SeguierMaximilien/GouGouGaGAH_DomotiqueESP32/docs/dossier_conception/Dossier_conception_AssistDomo_SEGUIER.pdf

# IUT de Toulon, département GEII SAE3.ESE.01-02 Concevoir-Vérifier

# Dossier de conception

# Assistant domotique « Yuki » ESP32-C6 et Home Assistant

# Schéma fonctionnel · Schéma structurel · Captures Home Assistant Annexes : code Arduino, codes et configuration Home Assistant

# Maximilien SEGUIER Enseignant : M. GIBERT Rendu le 1er novembre 2026

# Sommaire

# 1. Schéma fonctionnel

# 2. Schéma structurel (KiCad)

# 3. Captures d'écran Home Assistant

# Annexe A. Code Arduino du programme final

# Annexe B. Codes et configuration Home Assistant

# Présentation du système

L'assistant domotique Yuki affiche des informations sur l'habitation et permet de la piloter. Une

# carte à base de nanoESP32-C6 mesure la lumière (BH1750), la température et la pression

(BMP280) et la présence de gaz (MQ). Elle lit les badges RFID (RC522) pour commander la gâche de la porte par le relais K1, affiche les données sur un écran tactile ILI9341 et fournit une sortie PWM pour la gradation d'un éclairage ou la vitesse d'une VMC. La LED RGB de la carte indique la couleur Tempo EDF du jour et du lendemain et clignote pour attester que le programme tourne.

# La carte communique en WiFi avec Home Assistant (Raspberry Pi 3) par le protocole MQTT :

les entités sont créées automatiquement par la découverte MQTT, avec historique, tableau de bord et automatisations. Le tableau de bord est accessible sur le réseau local et à distance par le VPN Tailscale, sans ouverture de port sur la box.

Dossier de conception AssistDomo - SAE3.ESE.01-02 - Maximilien SEGUIER | 2 / 27

# 1. Schéma fonctionnel

# Habitation

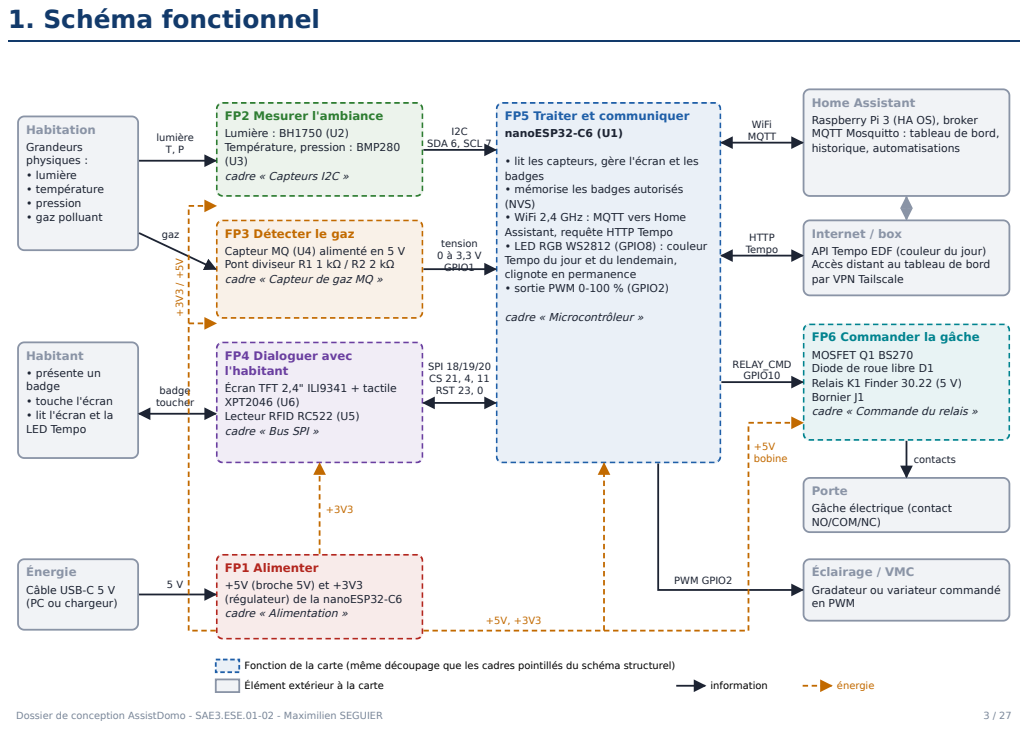
[picture p1: page 3]
Grandeurs physiques : • lumière • température • pression • gaz polluant; FP2 Mesurer l'ambiance Lumière : BH1750 (U2) Température, pression : BMP280 (U3) cadre « Capteurs I2C »; cadre « Microcontrôleur »; lumière T, P; gaz; badge toucher; I2C SDA 6, SCL 7; tension 0 à 3,3 V GPIO1; SPI 18/19/20 CS 21, 4, 11 RST 23, 0; WiFi MQTT; HTTP Tempo; RELAY_CMD GPIO10; contacts; PWM GPIO2 5 V; +5V bobine; Élément extérieur à la carte; information; énergie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

Home Assistant
Raspberry Pi 3 (HA OS), broker
MQTT Mosquitto : tableau de bord,
historique, automatisations

FP5 Traiter et communiquer
nanoESP32-C6 (U1)

• lit les capteurs, gère l'écran et les
badges
• mémorise les badges autorisés
(NVS)
• WiFi 2,4 GHz : MQTT vers Home
Assistant, requête HTTP Tempo
• LED RGB WS2812 (GPIO8) : couleur
Tempo du jour et du lendemain,
clignote en permanence
• sortie PWM 0-100 % (GPIO2)

FP3 Détecter le gaz
Capteur MQ (U4) alimenté en 5 V
Pont diviseur R1 1 kΩ / R2 2 kΩ
cadre « Capteur de gaz MQ »

Internet / box
API Tempo EDF (couleur du jour)
Accès distant au tableau de bord
par VPN Tailscale

FP6 Commander la gâche
MOSFET Q1 BS270
Diode de roue libre D1
Relais K1 Finder 30.22 (5 V)
Bornier J1
cadre « Commande du relais »

Habitant
• présente un
badge
• touche l'écran
• lit l'écran et la
LED Tempo

FP4 Dialoguer avec
l'habitant
Écran TFT 2,4" ILI9341 + tactile
XPT2046 (U6)
Lecteur RFID RC522 (U5)
cadre « Bus SPI »

Porte
Gâche électrique (contact
NO/COM/NC)

Énergie
Câble USB-C 5 V
(PC ou chargeur)

FP1 Alimenter
+5V (broche 5V) et +3V3
(régulateur) de la nanoESP32-C6
cadre « Alimentation »

Éclairage / VMC
Gradateur ou variateur commandé
en PWM

Fonction de la carte (même découpage que les cadres pointillés du schéma structurel)

# Description des fonctions

Fonction | Composants | Rôle
FP1 Alimenter | nanoESP32-C6 (U1) : broches 5V et 3V3 | Fournit le +5V (MQ, bobine du relais) et le +3V3 (capteurs I2C, écran, RFID) à partir de l'USB-C.
FP2 Mesurer l'ambiance | BH1750 GY-302 (U2), BMP280 (U3) | Mesure l'éclairement (lx), la température (°C) et la pression (hPa). Bus I2C partagé, adresses 0x23 et 0x76.
FP3 Détecter le gaz | Module MQ (U4), R1 1 kΩ, R2 2 kΩ | Donne une tension image de la concentration de gaz. Le pont diviseur ramène la sortie 0-5 V à 0-3,33 V pour l'entrée analogique GPIO1.
FP4 Dialoguer avec l'habitant | Écran TFT 2,4" ILI9341 + XPT2046 (U6), RC522 (U5) | Affiche les mesures et les menus, reçoit les appuis tactiles, lit l'identifiant des badges. Bus SPI partagé, un chip select par module.
FP5 Traiter et communiquer | nanoESP32-C6 (U1) | Exécute le programme : contrôle d'accès, menus, mémoire des badges en NVS, MQTT vers Home Assistant, lecture de la couleur Tempo, LED RGB, sortie PWM.
FP6 Commander la gâche | BS270 (Q1), D1, relais Finder 30.22.7.005 (K1), bornier J1 | Le MOSFET commute la bobine 5 V du relais depuis GPIO10. D1 protège Q1 de la surtension à la coupure. Les contacts NO/COM/NC sortent sur J1 vers la gâche.

# Liaisons entre fonctions

Liaison | Nature | Signaux (GPIO de l'ESP32-C6)
FP2 → FP5 | numérique, I2C | SDA = GPIO6, SCL = GPIO7
FP3 → FP5 | analogique | MQ_AO divisé, 0 à 3,33 V sur GPIO1 (ADC 12 bits)
FP4 ↔ FP5 | numérique, SPI | SCK = GPIO18, MOSI = GPIO19, MISO = GPIO20 ; TFT_CS = 21, TFT_DC = 22, TFT_RST = 23, TOUCH_CS = 4, RFID_CS = 11, RFID_RST = 0
FP5 → FP6 | logique TOR | RELAY_CMD = GPIO10, actif à l'état haut
FP5 → éclairage / VMC | PWM | GPIO2, rapport cyclique 0 à 100 %
FP5 → LED RGB | série WS2812 | GPIO8 (LED intégrée à la carte)
FP5 ↔ Home Assistant | WiFi 2,4 GHz, MQTT | topics gougougagah/… (voir annexe B)
FP5 ↔ Internet | WiFi, HTTP | api-couleur-tempo.fr : couleur du jour et du lendemain
Dossier de conception AssistDomo - SAE3.ESE.01-02 - Maximilien SEGUIER | 4 / 27

# 2. Schéma structurel

Le schéma structurel a été saisi sous KiCad 10 (projet mSeguier/mSeguier.kicad_sch). Il reprend le découpage du schéma fonctionnel : chaque fonction est entourée d'un cadre en trait pointillé (Alimentation, Microcontrôleur, Capteurs I2C, Capteur de gaz MQ, Bus SPI, Commande du relais). Le schéma est reproduit à la page suivante (original au format A3, en vectoriel : il peut être agrandi).

# Nomenclature des repères

Repère | Désignation | Fonction | Remarque
U1 | MuseLab nanoESP32-C6 (2 × 15 broches) | FP5, FP1 | Microcontrôleur, WiFi, LED RGB WS2812
U2 | Module GY-302 BH1750 | FP2 | ADDR à GND : adresse 0x23
U3 | Module GY-BMP280 | FP2 | CSB à 3V3 (mode I2C), SDO à GND : adresse 0x76
U4 | Module capteur de gaz MQ | FP3 | Alimenté en 5 V, DO non utilisé
R1, R2 | Résistances 1 kΩ et 2 kΩ | FP3 | 5 V × 2k / (1k + 2k) = 3,33 V max
U5 | Module RFID RC522 | FP4 | Alimenté en 3,3 V uniquement
U6 | Écran TFT 2,4" ILI9341 + tactile XPT2046 (MSP2402) | FP4 | Rétroéclairage sur 3V3
Q1 | MOSFET canal N BS270 | FP6 | Commande de la bobine depuis GPIO10
D1 | Diode 1N4004 | FP6 | Roue libre, cathode côté +5V
K1 | Relais Finder 30.22.7.005.0010, 2RT, bobine 5 V | FP6 | 1er inverseur utilisé
J1 | Bornier à vis 3 points | FP6 | 1 = NO, 2 = COM, 3 = NC

# Dimensionnement de la commande du relais

La bobine 5 V du relais Finder 30.22 consomme environ 40 mA (résistance d'environ 125 Ω). Une

# sortie de l'ESP32-C6 ne peut pas fournir ce courant sous 5 V : le MOSFET BS270 (VGS(th)

inférieure à 2,5 V, ID max 400 mA) est commandé directement en 3,3 V par GPIO10 et commute

# la bobine côté masse. La diode D1 en parallèle sur la bobine écoule le courant de self à

l'ouverture et protège Q1.

Dossier de conception AssistDomo - SAE3.ESE.01-02 - Maximilien SEGUIER | 5 / 27

# VCC 1 GND 2 SCL 3 SDA 4 ADDR 5 U2BH1750 (GY-302) SDA/SS 1 SCK 2 MOSI 3 MISO 4

# TOUCH_CS RELAY_NO

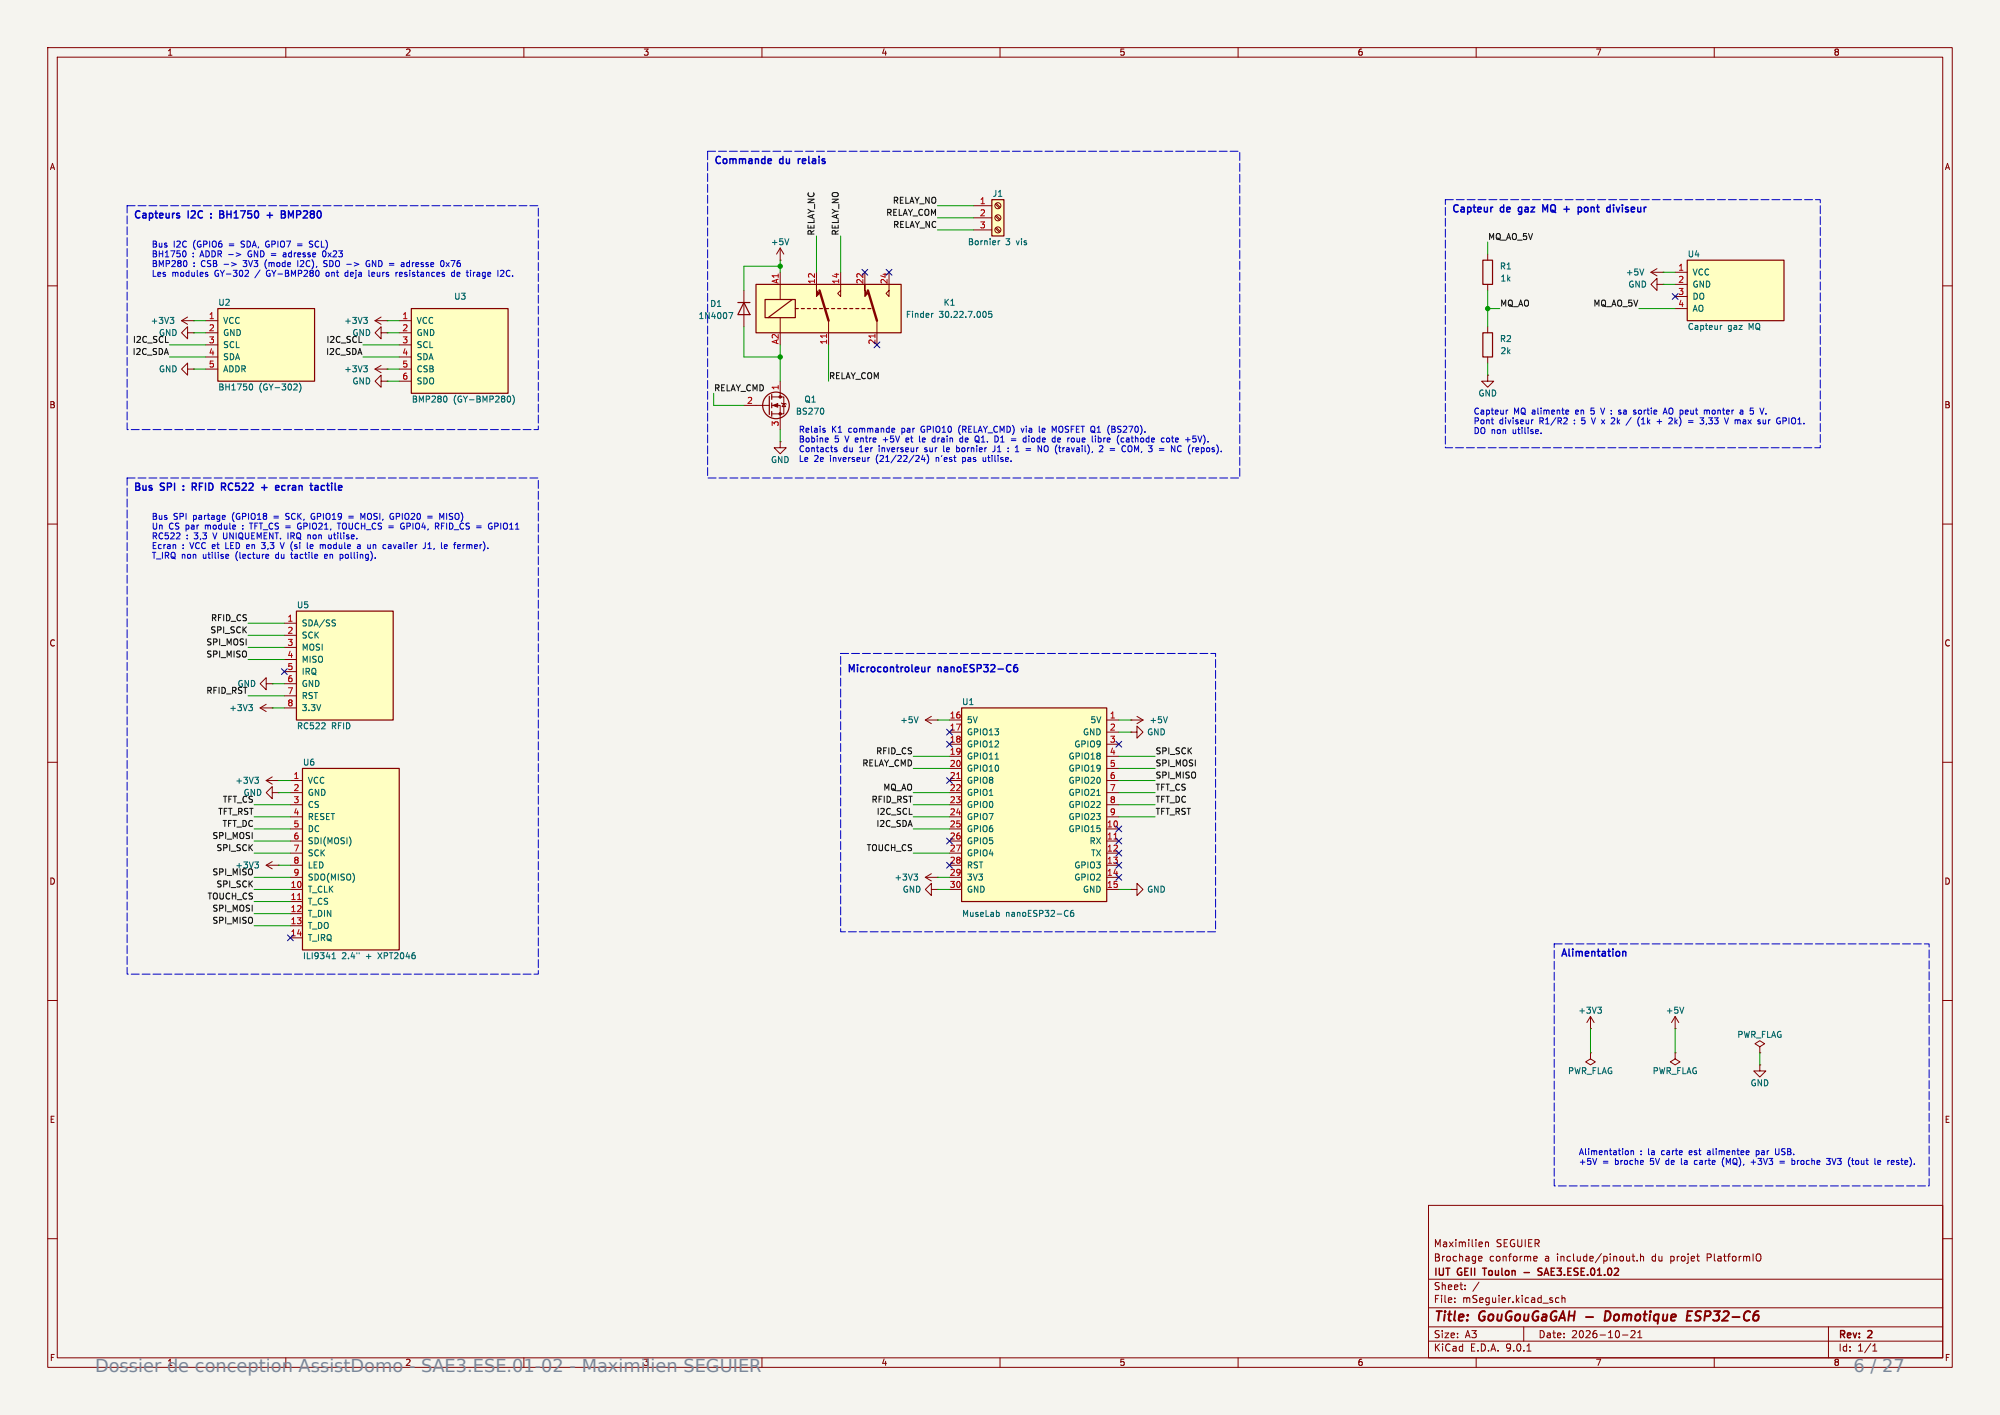
[picture p2: page 6]

VCC 1 GND 2 DO 3 AO 4 U4 Capteur gaz MQ GND

IRQ 5 GND 6 RST 7
LED 8 SDO(MISO) 9 T_CLK 10 T_CS 11 T_DIN 12 T_DO 13 T_IRQ 14 U6
VCC 1 GND 2 CS 3 RESET 4 DC 5 SDI(MOSI) 6 SCK 7

Id: 1/1 Title: GouGouGaGAH - Domotique ESP32-C6

# 3. Captures d'écran Home Assistant

Home Assistant OS est installé sur un Raspberry Pi 3 du réseau local. La carte s'y connecte en WiFi par le broker MQTT Mosquitto ; l'appareil de Yuki (nommé GouGouGaGAH dans Home Assistant) et ses entités apparaissent automatiquement (découverte MQTT).

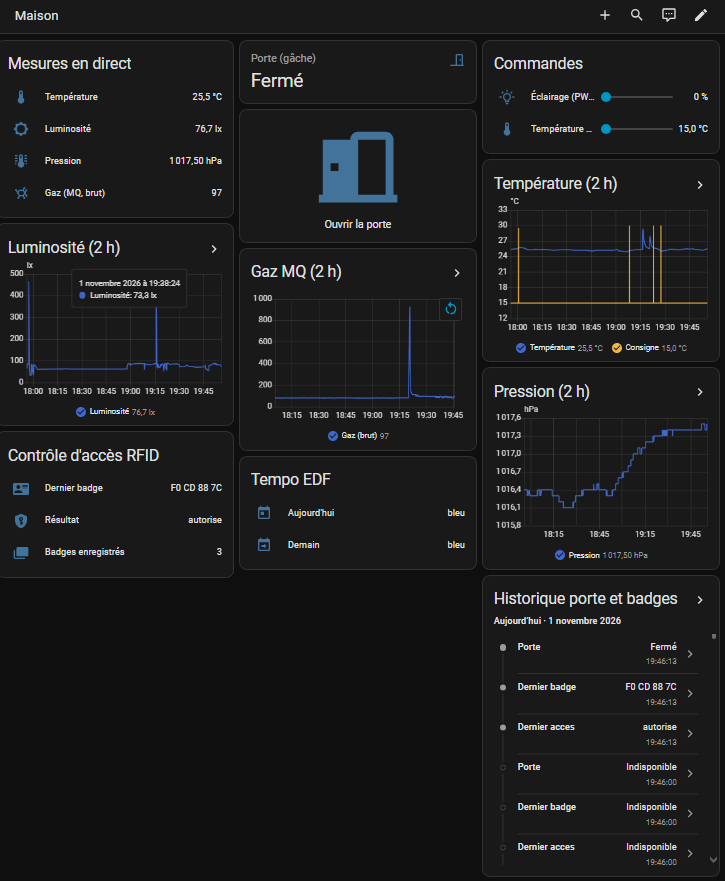
[picture p3: figure]

## Capture 1 : tableau de bord Home Assistant

Dossier de conception AssistDomo - SAE3.ESE.01-02 - Maximilien SEGUIER | 7 / 27

# Annexe A. Code Arduino de Yuki

Projet PlatformIO, framework Arduino (plateforme pioarduino), carte esp32-c6-devkitc-1. Code source complet du programme final. GouGouGaGAH est le nom interne de Yuki dans le code, les noms de dossiers, les topics MQTT et l'appareil Home Assistant. Dépôt GitHub SeguierMaximilien/GouGouGaGAH_DomotiqueESP32, dossier GouGouGaGAH_Application/. Le fichier secrets.h (mots de passe WiFi et MQTT) n'est pas publié : seul son modèle secrets_exemple.h figure ici.

Fichier | Rôle
platformio.ini | Configuration du projet et bibliothèques
pinout.h | Affectation des broches
secrets_exemple.h | Modèle des identifiants WiFi / MQTT
main.cpp | Initialisation des bus et des modules, boucle principale
module_acces | Contrôle d'accès : badges autorisés en NVS, ouverture de la porte 3 s
module_bh1750 | Capteur de lumière
module_bmp280 | Capteur de température et de pression
module_ha | WiFi, MQTT, découverte Home Assistant, ordres reçus
module_menu | Menus de l'écran tactile (Capteurs, Porte, Badges, Éclairage, Infos)
module_mq | Capteur de gaz (valeur brute ADC)
module_pwm | Sortie PWM 0-100 % sur GPIO2
module_relais | Commande du relais K1 (GPIO10)
module_rfid | Lecture des badges RC522
module_tempo | Couleur Tempo EDF (tâche FreeRTOS) et LED RGB clignotante
module_tft | Pilote de l'écran ILI9341 et du tactile XPT2046

## platformio.ini

1 ; PlatformIO Project Configuration File
2 ; https://docs.platformio.org/page/projectconf.html
3
4 [env:esp32-c6-devkitc-1]
5 platform = https://github.com/pioarduino/platform-espressif32/releases/download/stable/platform-espressif32.zip 6 board = esp32-c6-devkitc-1
7 framework = arduino
8 monitor_speed = 115200
9 ; WiFi + HTTPS + écran remplissent presque 1,3 Mo : on donne 3 Mo au programme 10 board_build.partitions = huge_app.csv
11
12 ; Décommente ces deux lignes seulement si tu branches le câble sur le port "USB" 13 ; de la carte (et pas sur le port "UART") et que le moniteur série reste muet. 14 ;build_flags =
15 ; | -D ARDUINO_USB_MODE=1
16 ; | -D ARDUINO_USB_CDC_ON_BOOT=1
17
18 lib_deps =
19 | claws/BH1750
20 | adafruit/Adafruit BMP280 Library
21 | adafruit/Adafruit Unified Sensor
22 | adafruit/Adafruit BusIO
23 | adafruit/Adafruit GFX Library
24 | adafruit/Adafruit ILI9341
25 | paulstoffregen/XPT2046_Touchscreen
26 | miguelbalboa/MFRC522
27 | knolleary/PubSubClient

## include/pinout.h

1 #ifndef PINOUT_H
2 #define PINOUT_H
3
4 // ======================================================== 5 // PINOUT - ESP32-C6-WROOM
6 // ======================================================== 7
8 // ---- Bus I2C (BH1750 + BMP280) ----
9 #define I2C_SDA | 6
10 #define I2C_SCL | 7
11
12 // ---- Bus SPI partagé (TFT + Tactile + RC522) ----
13 #define SPI_SCK | 18
14 #define SPI_MOSI | 19
15 #define SPI_MISO | 20
16
17 // ---- Ecran TFT ----
18 #define TFT_CS | 21
19 #define TFT_DC | 22
20 #define TFT_RST | 23
21 // LED (retroeclairage) -> 3V3 direct, pas de GPIO
22
23 // ---- Tactile (partage SPI_SCK / SPI_MOSI / SPI_MISO) ----24 #define TOUCH_CS 4
25
26 // ---- RFID RC522 (partage SPI_SCK / SPI_MOSI / SPI_MISO) ----
27 #define RFID_CS | 11
28 #define RFID_RST | 0
29
30 // ---- Capteur MQ (analogique) ----
31 #define MQ_AO | 1
32
33 // ---- Relais (via transistor, actif a l'etat haut) ----
34 #define RELAIS_PIN 10
35
36 // ---- LED RGB intégrée à la carte (WS2812) : couleur Tempo EDF ----37 #define LED_RGB 8

39 // ---- Sortie PWM (gradation d'éclairage / vitesse VMC) ----
40 #define PWM_PIN | 2
Dossier de conception AssistDomo - SAE3.ESE.01-02 - Maximilien SEGUIER | 8 / 27

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
E : c

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
e. s

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
b. 7 // ======================================================== 89 // ---- WiFi de la maison (2,4 GHz, l'ESP32 ne voit pas le

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
x : 1

9

2.1

6

8.1.1

1

0

). 15 #define MQTT_SERVEUR | "192.168.1.110" 16 #define MQTT_PORT | 1883 17 // Le compte "esp32" créé dans Home Assistant (Paramètres > Personnes

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
); 25 delay(1500); // laiss e

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
); 2728 | // Bus I2C : BH1750 + BMP280 29 | Wire.begin(I2C_SDA, I2C_SCL); 30 | // Bus SPI partagé : TFT + tactile + RC522 31 | SPI.begin(SPI_SCK, SPI_MISO, SPI_MOSI); 3233 | // Toutes les puces SPI désélectionnées avant d'initialiser q

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
S, O

U

T

P

U

T

); d

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
S, H

I

G

H

); 35 | pinMode(TOUCH_CS, OUTPUT); digitalWrite(TOUCH_CS, HIGH
); 36 | pinMode(RFID_CS, OUTPUT); digitalWrite(RFID_CS, HIGH); 3738 | bh1750_setup(); 39 | bmp280_setup(); 40 | mq_setup(); 41 | rfid_setup(); 42 | relais_setup(); 43 | pwm_setup(); 44 | tempo_setup(); 45 | acces_setup(); // badges autorisés lus en mémoire NVS 46 | tft_setup(); 47 | menu_setup(); | // écran tactile 48 | ha_setup(); | // WiFi + MQTT vers Home Assistant 49 } 5051 void loop() { 52 | acces_loop(); | // badges + gâche de porte 53 | menu_loop(); | // écran tactile 54 | ha_loop(); | // Home Assistant 55 | tempo_loop(); | // LED RGB Tempo (clignote en permanence

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
0; 59 | if (millis() - lastPrint > 5000) { 60 | lastPrint = millis(); 61 | Serial.println(String("Lux ") + b

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
" : "

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
" : S

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
); 68 } 69 }

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
s : b

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
). 78 // ACCES_VALIDATION : avant d'ajouter un badge, il faut d'abord passer un badge déjà

a

u

t

o

r

i

s

é. 9 enum ModeAcces { ACCES_NORMAL, ACCES_VALIDATION, ACCES_AJOUT, ACCES_SUPPRESSION }; 1011 // Charge la liste des badges autorisés depuis la mémoire NVS. 12 void acces_setup(); 1314 // À appeler à chaque tour de loop() : lit les badges et referme la porte après le délai. 15 void acces_loop();

Dossier de conception AssistDomo - SAE3.ESE.01-02 - Maximilien SEGUIER | 9 / 27

17 // Ouvre la porte (relais collé quelques secondes).
18 void acces_ouvrirPorte();
19 bool acces_porteOuverte();

21 // Le prochain badge présenté sera ajouté / supprimé (15 s pour le présenter).
22 // Pour l'ajout, il faut d'abord passer un badge déjà autorisé (sauf si la liste est vide). 23 void acces_demanderAjout();
24 void acces_demanderSuppression();
25 void acces_annulerMode();
26 ModeAcces acces_mode();
27
28 // Efface tous les badges autorisés. 29 void acces_toutEffacer();
30
31 int acces_nbBadges();
32
33 // Dernier événement lisible (ex : "04 A3 F1 2B : autorise"). 34 String acces_dernierMessage();
35
36 #endif // MODULE_ACCES_H

## include/module_bh1750.h

1 #ifndef MODULE_BH1750_H
2 #define MODULE_BH1750_H
3
4 #include <Arduino.h>
5
6 // Initialise le capteur BH1750 (I2C doit déjà être démarré avec Wire.begin()). 7 // Retourne true si le capteur a répondu correctement.
8 bool bh1750_setup();
9
10 // Retourne la dernière valeur de luminosité en lux.
11 // Retourne -1.0 si le capteur n'a pas été initialisé correctement. 12 float bh1750_readLux();
13
14 #endif // MODULE_BH1750_H

## include/module_bmp280.h

1 #ifndef MODULE_BMP280_H
2 #define MODULE_BMP280_H
3
4 #include <Arduino.h>
5
6 // Initialise le capteur BMP280 (I2C doit déjà être démarré avec Wire.begin()). 7 // Retourne true si le capteur a répondu correctement (adresse 0x76).
8 bool bmp280_setup();
9
10 // Retourne la dernière température lue en degrés Celsius.
11 // Retourne -999.0 si le capteur n'a pas été initialisé correctement. 12 float bmp280_readTemperature();
13
14 // Retourne la dernière pression lue en hPa.
15 // Retourne -1.0 si le capteur n'a pas été initialisé correctement. 16 float bmp280_readPressure();
17
18 #endif // MODULE_BMP280_H

## include/module_ha.h

1 #ifndef MODULE_HA_H
2 #define MODULE_HA_H
3
4 #include <Arduino.h>
5
6 // Liaison avec Home Assistant : WiFi + MQTT, avec découverte automatique
7 // (capteurs, porte, éclairage PWM et Tempo apparaissent tout seuls dans Home Assistant). 8 // Identifiants dans include/secrets.h (voir secrets_exemple.h).
9
10 // Lance la connexion WiFi (non bloquant).
11 void ha_setup();
12
13 // À appeler à chaque tour de loop() : garde WiFi + MQTT connectés,
14 // envoie les mesures toutes les 10 s et reçoit les ordres de Home Assistant.
15 void ha_loop();
16
17 // Signale un badge lu par le RC522 et ce qui en a été fait ("autorise", "refuse", "ajoute"...). 18 void ha_publierBadge(const String &uid, const String &resultat);
19
20 bool ha_wifiConnecte();
21 bool ha_estConnecte(); // connecté au broker MQTT
22
23 // Dernier ordre texte reçu sur gougougagah/ordre (automatisations Home Assistant) 24 String ha_dernierOrdre();
25
26 #endif // MODULE_HA_H

## include/module_menu.h

1 #ifndef MODULE_MENU_H
2 #define MODULE_MENU_H
3
4 #include <Arduino.h>
5
6 // Affiche le menu principal de test sur l'écran tactile
7 // (tft_setup() et les autres *_setup() doivent déjà avoir été appelés).
8 void menu_setup();
9
10 // À appeler à chaque tour de loop() : gère le tactile et rafraîchit l'écran affiché. 11 void menu_loop();
12
13 #endif // MODULE_MENU_H

## include/module_mq.h

1 #ifndef MODULE_MQ_H
2 #define MODULE_MQ_H

4 #include <Arduino.h>

Dossier de conception AssistDomo - SAE3.ESE.01-02 - Maximilien SEGUIER | 10 / 27

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
Q. 7 void mq_setup(); 89 // Retourne la valeur brute lue (0-4095 sur l'AD

C

b

d

l'E

S

P

). 10 int mq_readRaw(); 1112 // Retourne la valeur en pourcentage (0-100%) de la plage ADC. 13 float mq_readPercent(); 1415 #endif // MODULE_MQ_H

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
e, v

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
N. 78 void pwm_setup(); 9

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
t, 1

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
). 11 void pwm_set(int pourcent); 1213 int pwm_get(); 1415 #endif // MODULE_PWM_H

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
). 7 void relais_setup(); 89 // Colle (true) ou relâche (false) le relais. 10 void relais_set(bool actif); 1112 // Inverse l'état du relais. 13 void relais_basculer(); 1415 // Retourne true si le relais est collé. 16 bool relais_estActif(); 1718 #endif // MODULE_RELAIS_H

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
). 7 // Retourne true si le module a répondu correctement. 8 bool rfid_setup(); 9

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
). S

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
e, 11 // retourne true et remplit uidStr avec l'UID en hexadécimal (ex: " 0

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
). 12 bool rfid_checkCard(String &uidStr); 1314 #endif // MODULE_RFID_H

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
n, a

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
e. 7 // La LED clignote en permanence : preuve que le programme tourne. 89 enum CouleurTempo { TEMPO_INCONNU = 0, TEMPO_BLEU = 1, TEMPO_BLANC = 2, TEMPO_ROUG

E

=

3

}; 1011 // Lance aussi une tâche de fond qui lit les couleurs sur internet toutes les heures 12 // (sans jamais bloquer le reste du programme). 13 void tempo_setup(); 1415 // À appeler à chaque tour de loop() : fait clignoter la LED. 16 void tempo_loop(); 1718 CouleurTempo tempo_aujourdhui(); 19 CouleurTempo tempo_demain(); 2021 // "bleu", "blanc", "rouge" ou "inconnu" 22 const char *tempo_nom(CouleurTempo c); 2324 #endif // MODULE_TEMPO_H

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
). 9 void tft_setup(); 1011 // Affiche un écran de test (blocs de couleu

r

+

t

e

x

t

e

). 12 void tft_showTestScreen(); 1314 // Affiche une ligne de texte à une position donnée (pe

h

). 15 void tft_printLine(int x, int y, const String &text); 16

Dossier de conception AssistDomo - SAE3.ESE.01-02 - Maximilien SEGUIER | 11 / 27

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
). S

l'é

h

é, 18 // remplit x/y avec les coordonnées brutes et retourne true. 19 bool tft_checkTouch(int &x, int &y); 2021 // Comme tft_checkTouch, mais convertit en pixels écran (0..tf

t.w

d

h

(

)

1, 0..t

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
). 23 bool tft_checkTouchPixel(int &x, int &y); 2425 // Affiche 4 croix à toucher, calcule la calibration et l'enre

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
h. 26 // Bloquant pendant la calibration. Retourne false si les points sont incohére
n

t

s. 27 bool tft_calibrerTactile(); 2829 // true si une calibration a déjà été enregistrée. 30 bool tft_estCalibre(); 3132 // Accès direct à l'écran, pour les modules qui dessinent eux-mêmes (menu...). 33 Adafruit_ILI9341 &tft_get(); 3435 #endif // MODULE_TFT_H

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
0; 8 static const unsigned long DUREE_ O

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
0; /

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
0; /

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
s; 12 static String badges[MA X

_

B

A

D

G

E

S

]; 13 static int nbBadges = 0; 1415 static ModeAcces mode = ACCES_NOR

M

A

L; 16 static unsigned long debutMode = 0; 17 static unsigned long debutOuverture =

0; 18 static bool porteOuverte = false; 19 static String dernierMessage = "-"; 2021 // -------------------------------------

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
e : "

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
F;..."
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
e; 26 for (int i =
0; i

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
s; i

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
";"; 28 | liste += badges[i]; 29 | } 30 | nvs.putString("liste", l

i

s

t

e

); 31 } 3233 static void charger() { 34 String liste = nvs.getString("

l

i

s

t

e

", "

"

); 35 | nbBadges = 0; 36 | int debut = 0; 37 | while (debut < (int)liste.length() && nbBa

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
(';', d

e

b

u

t

); 39 | if (fin < 0) fin = liste.length(); 40 | badges[nbBadges++] = liste.substring

(

d

e

b

u

t, f

i

n

); 41 | debut = fin + 1; 42 | } 43 } 4445 static int chercher(const String &uid) { 46 | for (int i = 0; i < nbBadges; i++) { 47 | if (badges[i] == uid) return i; 48 | } 49 | return -1; 50 } 5152 // --------------------------------------------------

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
d, c

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
" : "

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
t; 56 Serial.println("[Acces] " + dernierMessa
g

e

); 57 | ha_publierBadge(uid, resultat); 58 } 5960 static void traiterBadge(const String &uid) { 61 | int pos = chercher(uid); 62 | switch (mode) { 63 | case ACCES_NORMAL: 64 | if (pos >= 0) { 65 | signaler(uid, "autorise"); 66 | acces_ouvrirPorte(); 67 | } else { 68 | signaler(uid, "refuse"); 69 | } 70 | break; 71 | case ACCES_VALIDATION: 72 | if (pos >= 0) { 73 | signaler(uid, "valide, passe le nouvea

u

b

a

d

g

e

"

); 74 | mode = ACCES_AJOUT; 75 | debutMode = millis(); // 15 s de plus pour le no

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
d, "

r

e

f

u

s

e, a

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
); 78 | mode = ACCES_NORMAL; 79 | } 80 | break; 81 | case ACCES_AJOUT: 82 | if (pos >= 0) signaler(uid, "deja connu"
); 83 | else if (nbBadges >= MAX_BADGES) signaler(
u

i

d, "

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
); 84 | else { 85 | badges[nbBadges++] = uid; 86 | sauvegarder(); 87 | signaler(uid, "ajoute"); 88 | } 89 | mode = ACCES_NORMAL; 90 | break; 91 | case ACCES_SUPPRESSION: 92 | if (pos < 0) signaler(uid, "inconnu"); 93 | else { 94 | badges[pos] = badges[--nbBadges]; // le dernier prend sa plac

v

g

d

(

);

Dossier de conception AssistDomo - SAE3.ESE.01-02 - Maximilien SEGUIER | 12 / 27

g

(

d, "

m

"

); 97 | } 98 | mode = ACCES_NORMAL; 99 | break; 100 | } 101 } 102 103 // -------------------------------

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
", f

a

l

s

e

); 107 | charger(); 108 | Serial.printf("[Acces] %d b

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
", n

b

B

a

d

g

e

s

); 109 } 110 111 void acces_loop() { 112 | String uid; 113 | if (rfid_checkCard(uid)) traiterBadge(uid); 114 115 | if (mode != ACCES_NORMAL && millis() - debutMode > DUREE_MODE) { 116 | mode = ACCES_NORMAL; 117 | dernierMessage = "Temps depasse"; 118 | } 119 | if (porteOuverte && millis() - debutOuverture > DUREE_OUVERTURE) { 120 | porteOuverte = false; 121 | relais_set(false); 122 | } 123 } 124 125 void acces_ouvrirPorte() { 126 | porteOuverte = true; 127 | debutOuverture = millis(); 128 | relais_set(true); 129 } 130 131 bool acces_porteOuverte() { 132 | return porteOuverte; 133 } 134 135 void acces_demanderAjout() { 136 | // Liste vide : personne ne peut valider, le premier badge s'enregistre

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
T : A

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
N; 138 | debutMode = millis(); 139 } 140 141 void acces_demanderSuppression() { 142 | mode = ACCES_SUPPRESSION; 143 | debutMode = millis(); 144 } 145 146 void acces_annulerMode() { 147 | mode = ACCES_NORMAL; 148 } 149 150 ModeAcces acces_mode() { 151 | return mode; 152 } 153 154 void acces_toutEffacer() { 155 | nbBadges = 0; 156 | sauvegarder(); 157 | dernierMessage = "Tous les badges effaces"; 158 } 159 160 int acces_nbBadges() { 161 | return nbBadges; 162 } 163 164 String acces_dernierMessage() { 165 | return dernierMessage; 166 }

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
r; 5 static bool bh1750_ready =

f

a

l

s

e; 67 bool bh1750_setup() { 8 bh1750_ready = lightMeter.begin

(

B

H

1

7

5

0::C

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
); 9 if (bh1750_ready) {

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
); 11 | } else { 12 | Serial.println(F("[BH1750] ECHEC

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
); 13 | } 14 | return bh1750_ready; 15 } 1617 float bh1750_readLux() { 18 | if (!bh1750_ready) return -1.0; 19 | return lightMeter.readLightLevel(); 20 }

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
p; 6 static bool bmp280_ready = f

a

l

s

e; 78 bool bmp280_setup() { 9 | bmp280_ready = bmp.begin(0x76); 10 | if (bmp280_ready) { 11 | bmp.setSampling(Adafruit_BMP2

8

0::M

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
L, 12 | Adafruit_BMP280::SAMPLING_X2, 13 | Adafruit_BMP280::SAMPLING_X16, 14 | Adafruit_BMP280::FILTER_X16, 15 | Adafruit_BMP280::STANDBY_MS_50

0

); 16 | Serial.println(F("[BMP280] OK")); 17 | } else { 18 | Serial.println(F("[BMP280] ECHEC (essayer 0x77, ve

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
); 19 | }
Dossier de conception AssistDomo - SAE3.ESE.01-02 - Maximilien SEGUIER | 13 / 27

20 return bmp280_ready;
21 }

23 float bmp280_readTemperature() {
24 | if (!bmp280_ready) return -999.0;
25 | return bmp.readTemperature();
26 }
27
28 float bmp280_readPressure() {
29 | if (!bmp280_ready) return -1.0;
30 | return bmp.readPressure() / 100.0F; // Pa -> hPa
31 }

## src/module_ha.cpp

1 #include "module_ha.h"
2 #include "module_bh1750.h" 3 #include "module_bmp280.h" 4 #include "module_mq.h"
5 #include "module_acces.h" 6 #include "module_pwm.h"
7 #include "module_tempo.h" 8 #include <WiFi.h>
9 #include <PubSubClient.h>
10
11 #if __has_include("secrets.h")
12 #include "secrets.h"
13 #else
14 #warning "include/secrets.h manquant : copie secrets_exemple.h en secrets.h et remplis-le" 15 #include "secrets_exemple.h"
16 #endif
17
18 // Tous les messages de la carte commencent par ce préfixe
19 #define BASE | "gougougagah"
20 #define TOPIC_DISPO | BASE "/dispo" | // online / offline
21 #define TOPIC_ETAT | BASE "/etat" | // mesures en JSON
22 #define TOPIC_PORTE | BASE "/porte" | // ON (ouverte) / OFF
23 #define TOPIC_PORTE_CMD BASE "/porte/ouvrir" | // ordre d'ouverture venant de Home Assistant
24 #define TOPIC_PWM | BASE "/pwm" | // 0..100 %
25 #define TOPIC_PWM_CMD | BASE "/pwm/set"
26 #define TOPIC_BADGE | BASE "/badge" | // {"uid":...,"resultat":...}
27 #define TOPIC_ORDRE | BASE "/ordre" | // texte libre envoyé par les automatisations HA
28 #define TOPIC_HA_STATUS "homeassistant/status" // Home Assistant vient de (re)démarrer
29
30 static const unsigned long PERIODE_MESURES = 10000; // ms entre deux envois
31 static const unsigned long PERIODE_RECONNEXION = 10000;
32
33 static WiFiClient wifiClient;
34 static PubSubClient mqtt(wifiClient);
35 static bool mqttAnnonce = false;
36 static unsigned long dernierEnvoi = 0;
37 static unsigned long derniereTentative = 0;
38 static bool wifiAnnonce = false;
39 static int portePubliee = -1; // -1 = jamais envoyé 40 static int pwmPublie = -1;
41 static String dernierOrdre = "";
42
43 // ------------------------------------------------------ découverte HA ----44
45 // Bloc "appareil" commun : regroupe toutes les entités sous un seul appareil 46 static const char *APPAREIL =
47 | "\"dev\":{\"ids\":[\"" BASE "\"],\"name\":\"GouGouGaGAH\","
48 | "\"mf\":\"Witherwatch\",\"mdl\":\"ESP32-C6\"},"
49 | "\"avty_t\":\"" TOPIC_DISPO "\"";
50
51 static void annoncer(const char *type, const char *id, const String &champs) {
52 | String topic = String("homeassistant/") + type + "/" BASE "_" + id + "/config";
53 | String json = "{\"uniq_id\":\"" BASE "_" + String(id) + "\"," + champs + "," + APPAREIL + "}";
54 | mqtt.publish(topic.c_str(), json.c_str(), true);
55 }
56
57 // Capteur lu dans un champ JSON. mesure = true pour une valeur numérique (courbes + statistiques) 58 static void annoncerCapteur(const char *id, const char *nom, const char *topic, const char *champ,
59 | bool mesure, const char *classe, const char *unite, const char *icone) {
60 | String c = String("\"name\":\"") + nom + "\",\"stat_t\":\"" + topic + "\","
61 | "\"val_tpl\":\"{{ value_json." + champ + " }}\"";
62 | if (mesure) c += ",\"stat_cla\":\"measurement\"";
63 | if (classe) c += String(",\"dev_cla\":\"") + classe + "\"";
64 | if (unite) c += String(",\"unit_of_meas\":\"") + unite + "\"";
65 | if (icone) c += String(",\"ic\":\"") + icone + "\"";
66 | annoncer("sensor", id, c);
67 }
68
69 static void annoncerTout() {
70 | annoncerCapteur("lux", "Luminosite", TOPIC_ETAT, "lux", true, "illuminance", "lx", nullptr);
71 | annoncerCapteur("temperature", "Temperature", TOPIC_ETAT, "temperature", true, "temperature", "°C", nullptr);
72 | annoncerCapteur("pression", "Pression", TOPIC_ETAT, "pression", true, "atmospheric_pressure", "hPa", nullptr);
73 | annoncerCapteur("gaz", "Gaz (brut)", TOPIC_ETAT, "gaz", true, nullptr, nullptr, "mdi:molecule");
74 | annoncerCapteur("badges", "Badges autorises", TOPIC_ETAT, "badges", true, nullptr, nullptr, "mdi:card-multiple");
75 | annoncerCapteur("tempo_jour", "Tempo aujourd'hui", TOPIC_ETAT, "tempo_jour", false, nullptr, nullptr, "mdi:calendar-today");
76 | annoncerCapteur("tempo_demain", "Tempo demain", TOPIC_ETAT, "tempo_demain", false, nullptr, nullptr, "mdi:calendar-arrow-right");
77 | annoncerCapteur("badge", "Dernier badge", TOPIC_BADGE, "uid", false, nullptr, nullptr, "mdi:card-account-details");
78 | annoncerCapteur("acces", "Dernier acces", TOPIC_BADGE, "resultat", false, nullptr, nullptr, "mdi:shield-key");
79
80 | annoncer("binary_sensor", "porte",
81 | "\"name\":\"Porte\",\"stat_t\":\"" TOPIC_PORTE "\",\"dev_cla\":\"door\"");
82 | annoncer("button", "ouvrir",
83 | "\"name\":\"Ouvrir la porte\",\"cmd_t\":\"" TOPIC_PORTE_CMD "\",\"ic\":\"mdi:door-open\"");
84 | annoncer("number", "pwm",
85 | "\"name\":\"Eclairage\",\"cmd_t\":\"" TOPIC_PWM_CMD "\",\"stat_t\":\"" TOPIC_PWM "\","
86 | "\"min\":0,\"max\":100,\"step\":5,\"unit_of_meas\":\"%\",\"mode\":\"slider\","
87 | "\"ic\":\"mdi:lightbulb-on-outline\"");
88
89 Serial.println(F("[HA] Entites annoncees a Home Assistant"));
90 }
91
92 // ------------------------------------------------------------ envois ----
93
94 // Une valeur invalide (capteur absent) part en "null" : Home Assistant affiche "inconnu" 95 static String valeur(float v, bool valide, int decimales) {
96 return valide ? String(v, decimales) : String("null");
97 }
98
99 static void envoyerMesures() {
100 | float lux = bh1750_readLux();
101 | float t = bmp280_readTemperature();
102 | float p = bmp280_readPressure();
Dossier de conception AssistDomo - SAE3.ESE.01-02 - Maximilien SEGUIER | 14 / 27

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
x, l

x

>

=

0, 1

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
t, t

>

0, 1

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
p, p

>

=

0, 1

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
"; 110 | mqtt.publish(TOPIC_ETAT, json.c_str()); 111 } 112 113 static void envoyerPorte() { 114 | portePubliee = acces_porteOuverte() ? 1 : 0; 115 | mqtt.publish(TOPIC_PORTE, portePubliee ? "ON" : "OFF", true); 116 } 117 118 static void envoyerPwm() { 119 | pwmPublie = pwm_get(); 120 | mqtt.publish(TOPIC_PWM, String(pwmPublie).c_str(), true); 121 } 122 123 // ---------------------------------------------------------- réception ---
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
c, b

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
d, u

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
g; 127 for (unsign
e

d

i

n

t

i

=

0; i

<

l

e

n; i

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
]; 128 129 | if (strcmp(topic, TOPIC_PORTE_CMD) == 0) { 130 | Serial.println(F("[HA] Ordre : ouvrir la porte")); 131 | acces_ouvrirPorte(); 132 | } else if (strcmp(topic, TOPIC_PWM_CMD) == 0) { 133 | Serial.println("[HA] Eclairage : " + msg + " %"); 134 | pwm_set(msg.toInt()); 135 | } else if (strcmp(topic, TOPIC_ORDRE) == 0) { 136 | dernierOrdre = msg; 137 | Serial.println("[HA] >>> ORDRE RECU : " + msg); 138 | } else if (strcmp(topic, TOPIC_HA_STATUS) == 0 && msg == "onlin

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
); /

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
é : o

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
d... ", M

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
R, M

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
); 147 | String id = String(BASE "-") + String((uint32_t)ESP.getEfuseMac(), HEX); 148 | // Testament : si la carte disparaît, le broker publie "offline" à sa plac

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
), M

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
R, M

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
E, 150 | TOPIC_DISPO, 0, true, "offline")) { 151 | // 4/5 = mauvais identifiants, -2 = broker injoignable (IP ? M

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
", m

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
); 153 | return; 154 | } 155 | Serial.println(F("OK")); 156 | mqtt.publish(TOPIC_DISPO, "online", true); 157 | annoncerTout(); 158 | mqtt.subscribe(TOPIC_PORTE_CMD); 159 | mqtt.subscribe(TOPIC_PWM_CMD); 160 | mqtt.subscribe(TOPIC_ORDRE); 161 | mqtt.subscribe(TOPIC_HA_STATUS); 162 | envoyerPorte(); 163 | envoyerPwm(); 164 | envoyerMesures(); 165 | dernierEnvoi = millis(); 166 } 167 168 // --------------------------------------------------

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
); 172 WiFi.setAutoReconnec t

(

t

r

u

e

); 173 WiFi.setSleep(false); // san s

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
D, W

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
); 175 Serial.printf("[WiFi] Connexion a \"%s\ "...\

n

", W

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
); 176 177 | mqtt.setServer(MQTT_SERVEUR, MQTT_PORT); 178 | mqtt.setCallback(recevoir); 179 | mqtt.setBufferSize(1024); // les messages de découverte dép

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
); /

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
); /

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
| m e

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
); /

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
) !=

W

L

_

C

O

| N N

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
| l.p r

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
); 188 | wifiAnnonce = false; 189 | return; 190 | } 191 | if (!wifiAnnonce) { 192 | wifiAnnonce = true; 193 | Serial.print(F("[WiFi] OK, adresse IP ")); 194 | Serial.println(WiFi.localIP()); 195 | derniereTentative = 0; // tente MQTT tout de suite 196 | } 197 198 | if (!mqtt.connected()) { 199 | if (mqttAnnonce) { 200 | mqttAnnonce = false; 201 | Serial.printf("[HA] MQTT deconnecte (etat %d, WiFi %d dBm)\n

", m

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
), W

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
); 202 | } 203 | if (derniereTentative == 0 || millis() - derniereTentative > PERIODE_RECONNEXION) { 204 | derniereTentative = millis(); 205 | connecterMqtt(); 206 | } 207 | return; 208 | } 209 210 | mqttAnnonce = true; 211 | mqtt.loop(); 212 | // Changements faits depuis l'écran ou par un badge : on prévient tout de suite 213 | if (portePubliee != (acces_porteOuverte() ? 1 : 0)) envoyerPorte(); 214 | if (pwmPublie != pwm_get()) envoyerPwm(); 215 | if (millis() - dernierEnvoi > PERIODE_MESURES) { 216 | dernierEnvoi = millis(); 217 | envoyerMesures(); 218 | } 219 } 220 221 void ha_publierBadge(const String &uid, const String &resultat) {
Dossier de conception AssistDomo - SAE3.ESE.01-02 - Maximilien SEGUIER | 15 / 27

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
n; 223 String json = "{\"uid\":\"" + d

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
"; 224 | mqtt.publish(TOPIC_BADGE, json.c_str(), true); 225 } 226 227 bool ha_wifiConnecte() { 228 | return WiFi.status() == WL_CONNECTED; 229 } 230 231 bool ha_estConnecte() { 232 | return mqtt.connected(); 233 } 234 235 String ha_dernierOrdre() { 236 | return dernierOrdre; 237 }

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
n : l

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
s. 1314 enum Ecran { MENU, CAPTEURS, PORTE, BADGES, ECLAIRAGE, INFOS, CALIBRER }; 1516 struct Bouton { 17 | int x, y, w, h; 18 | const char *texte; 19 | uint16_t couleur; 20 }; 2122 static const int NB_BOUTONS = 6; 23 static Bouton boutons[NB_BOUTONS]; 24 static const Ecran cibles[NB_BOUTONS] = { CAPTEURS, PORTE, BADGES, ECLAIRAGE, INFOS, C

A

L

I

B

R

E

R

}; 25 static Bouton retour; 26 static Bouton btnOuvrir; | // écran Porte 27 static Bouton btnAjouter, btnSupprimer, btnEffacer; | // écran Badges 28 static Bouton btnMoins, btnPlus; | // écran Eclairage 2930 static Ecran ecranActuel = MENU; 31 static unsigned long dernierRafraichissement = 0; 32 static bool doigtPose = false; | // pour ne réagir qu'au moment où on pose le doigt 33 static unsigned long dernierContact = 0; // anti-rebond : relâché seulement après 150 ms sans co

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
0; /

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
| & b

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
); 40 tft.fillRoundRect(b.x, b.y, b.w, b.h, 8, b.c o

u

l

e

u

r

); 41 tft.drawRoundRect(b.x, b.y, b.w, b.h, 8, ILI9341_WHI
T

E

); 42 | tft.setTextSize(2); 43 | tft.setTextColor(ILI9341_WHITE); 44 | int largeurTexte = strlen(b.texte) * 12; // 6 px par car

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
2, b.y

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
); 46 | tft.print(b.texte); 47 } 4849 static bool estDans(const Bouton &b, int x, int y) { 50 | return x >= b.x && x < b.x + b.w && y >= b.y && y < b.y + b.h; 51 } 5253 static void dessinerTitre(const char *titre) { 54 | Adafruit_ILI9341 &tft = tft_get(); 55 | tft.fillScreen(ILI9341_BLACK); 56 | tft.fillRect(0, 0, tft.width(), 40, ILI9341_NAVY); 57 | tft.setTextSize(2); 58 | tft.setTextColor(ILI9341_WHITE); 59 | tft.setCursor(retour.x + retour.w + 10, 12); 60 | tft.print(titre); 61 | dessinerBouton(retour); 62 } 6364 // Efface une zone puis y écrit une valeur (évite le scintillement d'u

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
). 65 static void ecrireValeur(int y, const String &texte, uint8_t taille, uint16_t couleu r

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
); 67 tft.fillRect(0, y, tft.width(), 8 *

t

a

i

l

l

e

+

4, I

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
); 68 | tft.setTextSize(taille); 69 | tft.setTextColor(couleur); 70 | tft.setCursor(10, y); 71 | tft.print(texte); 72 } 7374 static uint16_t couleurTempo(CouleurTempo c) { 75 | switch (c) { 76 | case TEMPO_BLEU: return ILI9341_BLUE; 77 | case TEMPO_BLANC: return ILI9341_WHITE; 78 | case TEMPO_ROUGE: return ILI9341_RED; 79 | default: | return ILI9341_DARKGREY; 80 | } 81 } 8283 static void afficherMenu() { 84 | Adafruit_ILI9341 &tft = tft_get(); 85 | tft.fillScreen(ILI9341_BLACK); 86 | tft.setTextSize(2); 87 | tft.setTextColor(ILI9341_GREEN); 88 | tft.setCursor(10, 12); 89 | tft.print("Assistant domotique"); 90 | for (int i = 0; i < NB_BOUTONS; i++) dessinerBouton(boutons[i]); 91 } 9293 static void afficherEcran(Ecran e) { 94 | ecranActuel = e; 95 | dernierRafraichissement = 0; // force un rafraîchissement immédi

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
Dossier de conception AssistDomo - SAE3.ESE.01-02 - Maximilien SEGUIER | 16 / 27

99 | afficherMenu();
100 | break;
101 | case CAPTEURS:
102 | dessinerTitre("Capteurs");
103 | break;
104 | case PORTE:
105 | dessinerTitre("Porte");
106 | dessinerBouton(btnOuvrir);
107 | break;
108 | case BADGES:
109 | dessinerTitre("Badges");
110 | dessinerBouton(btnAjouter);
111 | dessinerBouton(btnSupprimer);
112 | dessinerBouton(btnEffacer);
113 | break;
114 | case ECLAIRAGE:
115 | dessinerTitre("Eclairage (PWM)");
116 | dessinerBouton(btnMoins);
117 | dessinerBouton(btnPlus);
118 | break;
119 | case INFOS:
120 | dessinerTitre("Infos");
121 | break;
122 | case CALIBRER:
123 | tft_calibrerTactile();
124 | doigtPose = true; // le stylet vient d'être levé : pas de clic fantôme
125 | afficherEcran(MENU);
126 | break;
127 | }
128 }
129
130 // --------------------------------------------------- mise à jour des écrans ----131
132 static String texteLux() {
133 | float lux = bh1750_readLux();
134 | return lux < 0 ? String("non detecte") : String(lux, 1) + " lux";
135 }
136
137 static String texteTemperature() {
138 | float t = bmp280_readTemperature();
139 | return t < -900 ? String("non detecte") : String(t, 1) + " C";
140 }
141
142 static String textePression() {
143 | float p = bmp280_readPressure();
144 | return p < 0 ? String("non detecte") : String(p, 1) + " hPa";
145 }
146
147 static void dessinerJauge(int pourcent) {
148 | Adafruit_ILI9341 &tft = tft_get();
149 | int x = 20, y = 150, w = tft.width() - 40, h = 30;
150 | tft.drawRect(x, y, w, h, ILI9341_WHITE);
151 | int plein = (w - 4) * pourcent / 100;
152 | tft.fillRect(x + 2, y + 2, plein, h - 4, ILI9341_YELLOW);
153 | tft.fillRect(x + 2 + plein, y + 2, w - 4 - plein, h - 4, ILI9341_BLACK);
154 }
155
156 static void rafraichir() {
157 | switch (ecranActuel) {
158 | case CAPTEURS:
159 | ecrireValeur(55, "Lumiere : " + texteLux(), 2, ILI9341_YELLOW);
160 | ecrireValeur(85, "Temp. | : " + texteTemperature(), 2, ILI9341_ORANGE);
161 | ecrireValeur(115, "Pression: " + textePression(), 2, ILI9341_CYAN);
162 | ecrireValeur(145, "Gaz | : " + String(mq_readRaw()) + " / 4095", 2, ILI9341_GREEN);
163 | ecrireValeur(175, "Porte | : " + String(acces_porteOuverte() ? "ouverte" : "fermee"), 2, ILI9341_WHITE);
164 | ecrireValeur(205, "Eclair. : " + String(pwm_get()) + " %", 2, ILI9341_WHITE);
165 | break;
166 | case PORTE:
167 | ecrireValeur(160, acces_porteOuverte() ? "Porte OUVERTE" : "Porte fermee", 3,
168 | acces_porteOuverte() ? ILI9341_GREEN : ILI9341_WHITE);
169 | ecrireValeur(205, acces_dernierMessage(), 1, ILI9341_LIGHTGREY);
170 | break;
171 | case BADGES: {
172 | ecrireValeur(55, String("Badges autorises : ") + acces_nbBadges(), 2, ILI9341_WHITE);
173 | String etat;
174 | uint16_t couleur = ILI9341_YELLOW;
175 | if (acces_mode() == ACCES_VALIDATION) etat = "Passe un badge autorise";
176 | else if (acces_mode() == ACCES_AJOUT) etat = "Passe le NOUVEAU badge";
177 | else if (acces_mode() == ACCES_SUPPRESSION) etat = "Passe le badge a enlever";
178 | else if (effacerArme && millis() - effacerArme < 3000) {
179 | etat = "Re-appuie : tout effacer";
180 | couleur = ILI9341_RED;
181 | } else {
182 | etat = acces_dernierMessage();
183 | couleur = ILI9341_LIGHTGREY;
184 | }
185 | ecrireValeur(150, etat, 2, couleur);
186 | break;
187 | }
188 | case ECLAIRAGE:
189 | ecrireValeur(110, String(pwm_get()) + " %", 3, ILI9341_YELLOW);
190 | dessinerJauge(pwm_get());
191 | break;
192 | case INFOS:
193 | ecrireValeur(50, ha_wifiConnecte() ? "WiFi : " + WiFi.localIP().toString() : String("WiFi : connexion..."),
194 | 2, ha_wifiConnecte() ? ILI9341_GREEN : ILI9341_ORANGE);
195 | ecrireValeur(80, ha_estConnecte() ? "Home Assistant : OK" : "Home Assistant : --",
196 | 2, ha_estConnecte() ? ILI9341_GREEN : ILI9341_ORANGE);
197 | ecrireValeur(120, String("Tempo jour : ") + tempo_nom(tempo_aujourdhui()), 2,
198 | couleurTempo(tempo_aujourdhui()));
199 | ecrireValeur(150, String("Tempo demain: ") + tempo_nom(tempo_demain()), 2,
200 | couleurTempo(tempo_demain()));
201 | ecrireValeur(190, ha_dernierOrdre().length() ? "Ordre : " + ha_dernierOrdre() : String("Ordre : aucun"),
202 | 1, ILI9341_CYAN);
203 | break;
204 | default:
205 | break;
206 | }
207 }
208
209 // Un appui (doigt qui vient de se poser) sur l'écran en cours 210 static void toucher(int x, int y) {
211 | if (ecranActuel == MENU) {
212 | for (int i = 0; i < NB_BOUTONS; i++) {
213 | if (estDans(boutons[i], x, y)) { afficherEcran(cibles[i]); return; }
214 | }
215 | return;
216 | }
217 | if (y < 40) { // toute la barre de titre sert de bouton retour
Dossier de conception AssistDomo - SAE3.ESE.01-02 - Maximilien SEGUIER | 17 / 27

_

M

d

(

); 219 | afficherEcran(MENU); 220 | return; 221 | } 222 223 | switch (ecranActuel) { 224 | case PORTE: 225 | if (estDans(btnOuv

r

i

r, x, y

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
); 226 | break; 227 | case BADGES: 228 | if (estDans(btnAjouter, x, y)) acces_demanderAjout

(

); 229 | else if (estDans(btnSupprimer, x, y)) acces_demanderS
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
); 230 | else if (estDans(btnEffacer, x, y)) { 231 | if (effacerArme && millis() - effacerArme < 3000) { 232 | acces_toutEffacer(); 233 | effacerArme = 0; 234 | } else { 235 | effacerArme = millis(); 236 | } 237 | } 238 | break; 239 | case ECLAIRAGE: 240 | if (estDans(btnMoins, x, y)) pwm_set(pwm_get() - 10); 241 | else if (estDans(btnPlus, x, y)) pwm_set(pwm_get() + 10); 242 | break; 243 | default: 244 | break; 245 | } 246 | dernierRafraichissement = 0; 247 } 248 249 // ------------------------------------------------------------------ AP

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
); 253 const int W = tft.width(), marge = 8, h

a

u

t

=

4

0; 254 255 | // Menu : grille de 3 x 2 boutons 256 | int w = (W - 4 * marge) / 3; 257 | int h = (tft.height() - haut - 3 * marge) / 2; 258 | const char *textes[NB_BOUTONS] = { "Capteurs", "

P

o

r

t

e

", "

B

a

d

g

e

s

", "

E

c

l

a

i

r.", "

I

n

f

o

s

", "

C

a

l

i

b."

}; 259 | uint16_t couleurs[NB_BOUTONS] = { ILI9341_DARKGREEN, ILI9341_ORANGE, ILI9341_PURPLE, 260 | ILI9341_OLIVE, ILI9341_NAVY, ILI9341_DARKGREY }; 261 | for (int i = 0; i < NB_BOUTONS; i++) { 262 | int col = i % 3, ligne = i / 3; 263 | boutons[i] = { marge + col * (w + marge), haut + marge + ligne * (h + marge), w, h, 264 | textes[i], couleurs[i] }; 265 | } 266 | retour = { 4, 4, 70, 32, "<", ILI9341_DARKGREY }; 267 268 | btnOuvrir | = { W / 2 - 100, 55, 200, 90, "OUVRIR", ILI9341_DARKGREEN }; 269 | int wb = (W - 4 * marge) / 3; 270 | btnAjouter | = { marge, | 85, wb, 50, "Ajouter", ILI9341_DARKGREEN }; 271 | btnSupprimer = { 2 * marge + wb, | 85, wb, 50, "Suppr.", ILI9341_MAROON }; 272 | btnEffacer | = { 3 * marge + 2 * wb, 85, wb, 50, "Tout", ILI9341_DARKGREY }; 273 | btnMoins | = { 20, | 55, 80, 50, "-10", ILI9341_DARKGREY }; 274 | btnPlus | = { W - 100, | 55, 80, 50, "+10", ILI9341_DARKGREY }; 275 276 | // Sans calibration, les boutons ne tombent pas sous le stylet : on calibre d'abord 277 | if (!tft_estCalibre()) { 278 | while (!tft_calibrerTactile()) {} 279 | } 280 | afficherEcran(MENU); 281 } 282 283 void menu_loop() { 284 | int x, y; 285 | bool touche = tft_checkTouchPixel(x, y); 286 | if (touche && !doigtPose) toucher(x, y); 287 | if (touche) { 288 | doigtPose = true; 289 | dernierContact = millis(); 290 | } else if (millis() - dernierContact > 150) { 291 | doigtPose = false; 292 | } 293 294 | if (ecranActuel != MENU && millis() - dernierRafraichissement > 500) { 295 | dernierRafraichissement = millis(); 296 | rafraichir(); 297 | } 298 }

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
O, I

N

P

U

T

); 6 Serial.println(F("[MQ] O

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
); 7 } 89 int mq_readRaw() {

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
); 11 } 1213 float mq_readPercent() { 14 return (analogRead(MQ_AO)

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
f; 15 }

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
0; /

/

H

z : p

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
8; /

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
0..2

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
0; 78 void pwm_setup() { 9 ledcAttach(PWM_PIN, FREQUENC

E, R

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
); 10 | pwm_set(0); 11 | Serial.println(F("[PWM] OK (0 %)")); 12 } 1314 void pwm_set(int pourcent) {
Dossier de conception AssistDomo - SAE3.ESE.01-02 - Maximilien SEGUIER | 18 / 27

A

=

(

t, 0, 1

); 16 | ledcWrite(PWM_PIN, pourcentActuel * 255 / 100
); 17 } 1819 int pwm_get() { 20 | return pourcentActuel; 21 }

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
e; 56 void relais_setup() { 7 | pinMode(RELAIS_PIN, OUTPUT); 8 | relais_set(false); 9 | Serial.println(F("[Relais] OK (

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
); 10 } 1112 void relais_set(bool actif) { 13 | relais_actif = actif; 14 | digitalWrite(RELAIS_PIN, actif ? HIGH : LOW); 15 | Serial.println(actif ? F("[Relais] ON") : F("[Relais]

O

F

F

"

)

); 16 } 1718 void relais_basculer() { 19 | relais_set(!relais_actif); 20 } 2122 bool relais_estActif() { 23 | return relais_actif; 24 }

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
S, R

F

I

D

_

R

S

T

); 7 static bool rfid_ready = false; 89 bool rfid_setup() {

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
); 11 byte version = r
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
); 12 | rfid_ready = (version != 0x00 && version != 0xFF); 1314 | if (rfid_ready) { 15 | Serial.print(F("[RC522] OK (version registre 0x")); 16 | Serial.print(version, HEX); 17 | Serial.println(F(")")); 18 | } else { 19 | Serial.println(F("[RC522] ECHEC (verifier SPI et ali

m

3.3

V, j

a

m

a

i

s

5

V !)

"

)

); 20 | } 21 | return rfid_ready; 22 } 2324 bool rfid_checkCard(String &uidStr) { 25 | if (!rfid_ready) return false; 26 | if (!rfid.PICC_IsNewCardPresent() || !rfid.PICC_ReadCardSerial()) { 27 | return false; 28 | } 2930 | uidStr = ""; 31 | for (byte i = 0; i < rfid.uid.size; i++) { 32 | if (rfid.uid.uidByte[i] < 0x10) uidStr += "0"; 33 | uidStr += String(rfid.uid.uidByte[i], HEX); 34 | if (i < rfid.uid.size - 1) uidStr += " "; 35 | } 36 | uidStr.toUpperCase(); 3738 | rfid.PICC_HaltA(); 39 | return true; 40 }

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
) : r

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
":1,...}

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
u, 2

b

l

a

n

c, 3

r

o

u

g

e. 8 // On essaie d'abord en http (léger, pas de chiffrement), puis en https si le serveur refuse. 9 #define URL_TEMPO_HTTP "http://www.api-couleur-tempo.fr/api/jourTempo/"

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
L; /

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
L; /

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
0; | /

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
d, l

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
U; 18 static volatile CouleurTempo demain = TEMPO_INCONNU; 19 static int phaseAffichee = -1; 2021 static CouleurTempo lireReponse(HTTPClient &http) { 22 | CouleurTempo c = TEMPO_INCONNU; 23 | if (http.GET() == HTTP_CODE_OK) { 24 | String json = http.getString(); 25 | int pos = json.indexOf("\"codeJour\":"); 26 | if (pos >= 0) { 27 | int code = json.substring(pos + 11).toInt(); 28 | if (code >= 1 && code <= 3) c = (CouleurTempo)code; 29 | } 30 | } 31 | http.end(); 32 | return c; 33 } 3435 // Lit /today ou /tomorrow ; TEMPO_INCONNU si la requête

é

h

Dossier de conception AssistDomo - SAE3.ESE.01-02 - Maximilien SEGUIER | 19 / 27

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
t; 38 | HTTPClient http; 39 | http.setConnectTim

(

); 40 | http.setTimeout(5000); 41 | CouleurTempo c = TEMPO_INCONN
U; 42 | if (http.begin(client, String(U
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
); 43 | if (c != TEMPO_INCONNU) return c; 4445 | WiFiClientSecure clientSecure; 46 | clientSecure.setInsecure(); // pas de vérification du certificat : suffisant

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
); 48 if (http.begin(clientSecure, String(U R

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
); 49 | return c; 50 } 5152 // Tâche de fond : les requêtes internet peuvent durer plusieurs secondes, 53 // elles ne doivent jamais bloquer l'écran, les badges ni Home Assistant. 54 static void tacheTempo(void *) { 55 | for (;;) { 56 | if (WiFi.status() != WL_CONNECTED) { 57 | vTaskDelay(pdMS_TO_TICKS(2000)); 58 | continue; 59 | } 60 | aujourdhui = lireJour("today"); 61 | demain = lireJour("tomorrow"); 62 | Serial.printf("[Tempo] aujourd'hui %s, demain %s\n", tempo_nom(aujourdhui), tempo_

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
); 63 | unsigned long attente = aujourdhui != TEMPO_INCONNU ? PERIODE_MAJ : PERIODE_ESSAI; 64 | vTaskDelay(pdMS_TO_TICKS(attente)); 65 | } 66 } 6768 static void allumer(CouleurTempo c) { 69 | switch (c) { 70 | case TEMPO_BLEU: rgbLedWrite(LED_RGB, 0, 0, 60); break; 71 | case TEMPO_BLANC: rgbLedWrite(LED_RGB, 40, 40, 40); break; 72 | case TEMPO_ROUGE: rgbLedWrite(LED_RGB, 60, 0, 0); break; 73 | default: | rgbLedWrite(LED_RGB, 30, 15, 0); break; // orange = couleur pas encore connue 74 | } 75 } 7677 // Sur un cycle de 2 s : couleur du jour (longue), pause, couleur du lendemain (courte), pause 78 static void clignoter() { 79 | unsigned long t = millis() % CYCLE_LED; 80 | int phase = t < 700 ? 0 : t < 1000 ? 1 : t < 1300 ? 2 : 3; 81 | if (phase == phaseAffichee) return; // on n'écrit dans la LED qu'aux changements 82 | phaseAffichee = phase; 83 | if (phase == 0) allumer(aujourdhui); 84 | else if (phase == 2) allumer(demain); 85 | else rgbLedWrite(LED_RGB, 0, 0, 0); 86 } 8788 void tempo_setup() { 89 | rgbLedWrite(LED_RGB, 0, 0, 0); 90 | xTaskCreate(tacheTempo, "tempo", 10240, nullptr, 1, nullptr); 91 | Serial.println(F("[Tempo] LED RGB prete")); 92 } 9394 void tempo_loop() { 95 | clignoter(); 96 } 9798 CouleurTempo tempo_aujourdhui() { 99 | return aujourdhui; 100 } 101 102 CouleurTempo tempo_demain() { 103 | return demain; 104 } 105 106 const char *tempo_nom(CouleurTempo c) { 107 | switch (c) { 108 | case TEMPO_BLEU: return "bleu"; 109 | case TEMPO_BLANC: return "blanc"; 110 | case TEMPO_ROUGE: return "rouge"; 111 | default: | return "inconnu"; 112 | } 113 }

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
1 : s

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
), e

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
e. O

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
r, m

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
0. 14 class EcranClone : public Adafruit_ILI9341 { 15 public: 16 | using Adafruit_ILI9341::Adafruit_ILI9341; 17 | void forcerTaille(int16_t w, int16_t h) { 18 | _width = w; 19 | _height = h; 20 | } 21 }; 2223 static EcranClone tft(TFT_CS, TFT_DC, TFT_RST); 24 static XPT2046_Touchscreen touch(TOUCH_CS); // pas d'IRQ, lecture en p

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
n. 28 // Un MIN plus grand que le MAX veut dire que l'axe est inversé (map() le gère
). 29 // "echange" : l'axe X de l'écran correspond à l'axe Y brut du tactile. 30 // Ces valeurs par défaut sont remplacées par celles de l'écran "Calibrer", 31 // enregistrées en mémoire flash (elles survivent au redémarrage et au reflash). 32 struct CalibTactile { 33 | int xMin, xMax, yMin, yMax; 34 | bool echange; 35 }; 36 static CalibTactile calib = { 300, 3800, 300, 3800, false };
Dossier de conception AssistDomo - SAE3.ESE.01-02 - Maximilien SEGUIER | 20 / 27

b

b

=

f

e; 3839 static const int TOUCH_PRESS

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
0; /

/

d

s, a

é

g

r : i

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
s; 43 prefs.begin("tacti
l

e

", t

r

u

e

); 44 | calibre = prefs.isKey("xMin"); 45 | if (calibre) { 46 | calib.xMin = prefs.getInt("x

M

i

n

"

); 47 | calib.xMax = prefs.getInt("xMax"); 48 | calib.yMin = prefs.getInt("yMin"); 49 | calib.yMax = prefs.getInt("yMax"); 50 | calib.echange = prefs.getBool("ech

a

n

g

e

"

); 51 Serial.printf("[Tactile] Calibration char g

e

e : X

%

d..%

d

Y

%

d..%

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
", 52 | calib.xMin, calib.xMax, calib.yMin, calib.yMax, calib.echange); 53 | } else { 54 | Serial.println(F("[Tactile] Pas encore calibre : menu > Calibrer")); 55 | } 56 | prefs.end(); 57 } 5859 static void tft_enregistrerCalibration() { 60 | Preferences prefs; 61 | prefs.begin("tactile", false); 62 | prefs.putInt("xMin", calib.xMin); 63 | prefs.putInt("xMax", calib.xMax); 64 | prefs.putInt("yMin", calib.yMin); 65 | prefs.putInt("yMax", calib.yMax); 66 | prefs.putBool("echange", calib.echange); 67 | prefs.end(); 68 } 6970 // Lit un registre de l'écran (lecture SPI générique, valable pour ILI9341 et ST7789). 71 // Le premier octet renvoyé par l'écran est un octet "fantôme", d'où index + 1. 72 static uint8_t tft_lireRegistre(uint8_t registre, uint8_t index) { 73 | return tft.Adafruit_SPITFT::readcommand8(registre, index + 1); 74 } 7576 // Affiche sur le moniteur série l'identifiant de l'écran et l'orientation réellement 77 // appliquée, pour savoir quel contrôleur se cache derrière le module. 78 static void tft_diagnostic() { 79 | Serial.print(F("[TFT] ID ecran (0x04) : ")); 80 | for (uint8_t i = 0; i < 3; i++) { 81 | Serial.print(tft_lireRegistre(0x04, i), HEX); 82 | Serial.print(' '); 83 | } 84 | Serial.print(F(" | ID4 (0xD3) : ")); 85 | for (uint8_t i = 0; i < 3; i++) { 86 | Serial.print(tft_lireRegistre(0xD3, i), HEX); 87 | Serial.print(' '); 88 | } 89 | Serial.print(F(" | MADCTL lu : 0x")); 90 | Serial.print(tft_lireRegistre(0x0B, 0), HEX); 91 | Serial.println(); 92 } 9394 // ---- Test des orientations au démarrage ---- 95 // Chaque réglage s'affiche 5 s avec une grande lettre. Note la lettre où le cadre bla

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
n, o

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
e, e

n

b

a

s. M

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
e. 99 #define TFT_TEST_ORIENTATIONS 0

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
G 'H' /

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
t : r

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
e; 104 uint8_t madc
t

l; /

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
B, s

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
n; 106 }; 107 108 static const ConfigEcran c

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
{ 'F', 0

x

0

0, "

3

2

0

x

2

4

0, n

o

r

m

a

l

"

}, 110 { 'G', 0x40, "320x240, miroir gau c

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
}, 111 | { 'H', 0x80, "320x240, miroir haut/bas" }, 112 | { 'I', 0xC0, "320x240, retourne (180 degres)" }, 113 }; 114 static const int NB_CONFIGS = sizeof(configs) / si

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
); 115 116 static void tft_appliquerConfig(const ConfigEcran &cfg) { 117 | tft.setRotation(0); // remet l'adressage de base du contrôleur 118 | uint8_t m = cfg.madctl; 119 | tft.sendCommand(0x36, &m, 1); 120 | tft.forcerTaille(320, 240); 121 | tft.fillScreen(ILI9341_BLACK); // efface toute la mémoire (320 x

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
), h

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
); 126 | tft.fillScreen(ILI9341_BLACK); 127 | tft.drawRect(0, 0, w, h, ILI9341_WHITE
); 128 | tft.drawRect(2, 2, w - 4, h - 4, ILI9341
_

W

H

I

T

E

); 129 | tft.setTextColor(ILI9341_WHITE); 130 | tft.setTextSize(8); 131 | tft.setCursor(w / 2 - 24, 20); 132 | tft.print(lettre); 133 | // Trois carrés : R doit être rouge, V vert, B b

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
D, I

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
N, I

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
}; 135 | const char lettres[3] = { 'R', 'V', 'B' }; 136 | for (int i = 0; i < 3; i++) { 137 | int x = w / 2 - 75 + i * 52; 138 | tft.fillRect(x, h - 70, 46, 46, couleurs[i]); 139 | tft.setTextSize(3); 140 | tft.setTextColor(ILI9341_WHITE); 141 | tft.setCursor(x + 14, h - 58); 142 | tft.print(lettres[i]); 143 | } 144 } 145 146 static void tft_testOrientations() { 147 | for (int i = 0; i < NB_CONFIGS; i++) { 148 | tft_appliquerConfig(configs[i]); 149 | tft_dessinerMire(configs[i].lettre); 150 | Serial.printf("[TFT] Test %c : %s\n", configs[i].lettre, configs[i].desc

r

i

p

t

i

o

n

); 151 | delay(5000); 152 | } 153 } 154 155 void tft_setup() {
Dossier de conception AssistDomo - SAE3.ESE.01-02 - Maximilien SEGUIER | 21 / 27

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
t : p

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
); 158 if (TFT_TEST_ORIENTA T

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
); 159 | for (int i = 0; i < NB_CONFIGS; i++) { 160 | if (configs[i].lettre == TFT_CONFIG) tft_appliqu

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
); 161 | } 162 | tft_diagnostic(); 163 | tft.fillScreen(ILI9341_BLACK); 164 | touch.begin(); 165 | touch.setRotation(0); // axes bruts : la calibration gère sens et échan

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
); 167 Serial.println(F("[TFT] O K

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
); 168 | Serial.println(F("[Tactile] OK (touche l'ecran pour tester)")); 169 } 170 171 void tft_showTestScreen() { 172 | tft.fillScreen(ILI9341_BLACK); 173 | tft.setCursor(10, 10); 174 | tft.setTextColor(ILI9341_GREEN); 175 | tft.setTextSize(2); 176 | tft.println("Diagnostic OK"); 177 178 | tft.setTextSize(1); 179 | tft.setTextColor(ILI9341_WHITE); 180 | tft.setCursor(10, 40); 181 | tft.println("Touche l'ecran pour"); 182 | tft.setCursor(10, 55); 183 | tft.println("tester le tactile."); 184 185 | tft.fillRect(10, 100, 40, 30, ILI9341_RED); 186 | tft.fillRect(60, 100, 40, 30, ILI9341_GREEN); 187 | tft.fillRect(110, 100, 40, 30, ILI9341_BLUE); 188 | tft.drawRect(160, 100, 40, 30, ILI9341_YELLOW); 189 } 190 191 void tft_printLine(int x, int y, const String &text) { 192 | tft.fillRect(x, y, 220, 12, ILI9341_BLACK); // efface la ligne

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
x, y

); 194 tft.setTextColor(ILI 9

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
); 195 | tft.setTextSize(1); 196 | tft.print(text); 197 } 198 199 // Le premier échantillon d'un app

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
) : 200 // on lit plusieurs points, on garde ceux assez appuyés et on prend la médiane. 201 bool tft_checkTouch(int &x, int &y) { 202 | if (!touch.touched()) return false; 203 | const int N = 7; 204 | int xs[N], ys[N], n = 0; 205 | for (int i = 0; i < N; i++) { 206 | TS_Point p = touch.getPoint(); 207 | if (p.z >= TOUCH_PRESSION_MIN) { 208 | xs[n] = p.x; 209 | ys[n] = p.y; 210 | n++; 211 | } 212 | delay(2); 213 | } 214 | if (n < 4) return false; // appui trop léger ou instable 215 | std::sort(xs, xs + n); 216 | std::sort(ys, ys + n); 217 | x = xs[n / 2]; 218 | y = ys[n / 2]; 219 | return true; 220 } 221 222 bool tft_checkTouchPixel(int &x, int &y) { 223 | int rx, ry; 224 | if (!tft_checkTouch(rx, ry)) return false; 225 | int a = calib.echange ? ry : rx; 226 | int b = calib.echange ? rx : ry; 227 | x = constrain(map(a, calib.xMin, calib.xMax, 0, tft.width() - 1), 0, tft.width() -

1

); 228 | y = constrain(map(b, calib.yMin, calib.yMax, 0, tft.height() - 1), 0, tft.height() - 1
); 229 | return true; 230 } 231 232 // ---- Écran de calibration ---- 233 234 static const int CALIB_MARGE = 20; // distance des croix aux bords 235 236 static void tft_dessinerCroix(int x, int y, uint16_t couleur) { 237 | tft.drawFastHLine(x - 10, y, 21, couleur); 238 | tft.drawFastVLine(x, y - 10, 21, couleur); 239 | tft.drawCircle(x, y, 5, couleur); 240 } 241 242 // Attend un appui franc, en fait la moyenne pendant ~300 ms, puis attend qu'on relâche. 243 static void tft_lireAppuiCalibration(int &rx, int &ry) { 244 | long sx, sy; 245 | int n; 246 | do { 247 | while (!touch.touched()) delay(10); 248 | delay(80); // laisse le stylet se poser 249 | sx = sy = n = 0; 250 | unsigned long debut = millis(); 251 | while (millis() - debut < 300) { 252 | int x, y; 253 | if (tft_checkTouch(x, y)) { sx += x; sy += y; n++; } 254 | } 255 | } while (n < 5); 256 | rx = sx / n; 257 | ry = sy / n; 258 | unsigned long relache = millis(); 259 | while (millis() - relache < 200) { // relâché depuis 200 ms 260 | if (touch.touched()) relache = millis(); 261 | delay(10); 262 | } 263 } 264 265 bool tft_calibrerTactile() { 266 | const int w = tft.width(), h = tft.height(), m = CALIB_MARGE; 267 | // Ordre : haut-gauche, haut-droite, bas-droite, bas-gauche 268 | const int cx[4] = { m, w - 1 - m, w - 1 - m, m }; 269 | const int cy[4] = { m, m, h - 1 - m, h - 1 - m }; 270 | int rx[4], ry[4]; 271 272 | for (int i = 0; i < 4; i++) { 273 | tft.fillScreen(ILI9341_BLACK); 274 | tft.setTextSize(2);
Dossier de conception AssistDomo - SAE3.ESE.01-02 - Maximilien SEGUIER | 22 / 27

tft.setTextColor(ILI9341_WHITE); tft.setCursor(40, h / 2 - 20); tft.print("Appuie au centre"); tft.setCursor(40, h / 2 + 4);
tft.printf("de la croix (%d/4)", i + 1);
tft_dessinerCroix(cx[i], cy[i], ILI9341_YELLOW);
tft_lireAppuiCalibration(rx[i], ry[i]);
Serial.printf("[Calib] point %d (%d,%d) : brut x=%d y=%d\n", i + 1, cx[i], cy[i], rx[i], ry[i]); }

// Quel axe brut varie quand on va de gauche à droite ?
int dxBrutX = abs((rx[1] + rx[2]) - (rx[0] + rx[3]));
int dxBrutY = abs((ry[1] + ry[2]) - (ry[0] + ry[3])); bool echange = dxBrutY > dxBrutX;
int a[4], b[4];
for (int i = 0; i < 4; i++) {
a[i] = echange ? ry[i] : rx[i];
b[i] = echange ? rx[i] : ry[i];
}
// Moyenne des deux croix de chaque bord, puis extrapolation jusqu'au bord de l'écran float gauche = (a[0] + a[3]) / 2.0f, droite = (a[1] + a[2]) / 2.0f;
float haut = (b[0] + b[1]) / 2.0f, bas = (b[2] + b[3]) / 2.0f;
float parPixelX = (droite - gauche) / (w - 1 - 2 * m);
float parPixelY = (bas - haut) / (h - 1 - 2 * m);

bool ok = fabsf(droite - gauche) > 800 && fabsf(bas - haut) > 600; tft.fillScreen(ILI9341_BLACK);
tft.setTextSize(2);
tft.setCursor(20, h / 2 - 10);
if (!ok) {
Serial.println(F("[Calib] ECHEC : points trop proches, recommence en appuyant bien sur les croix")); tft.setTextColor(ILI9341_RED);
tft.print("Echec, recommence");
delay(1500);
return false;
}
calib.xMin = lroundf(gauche - m * parPixelX); calib.xMax = lroundf(droite + m * parPixelX); calib.yMin = lroundf(haut - m * parPixelY); calib.yMax = lroundf(bas + m * parPixelY); calib.echange = echange;
tft_enregistrerCalibration();
calibre = true;
Serial.printf("[Calib] OK : X %d..%d Y %d..%d echange=%d (enregistre)\n", calib.xMin, calib.xMax, calib.yMin, calib.yMax, calib.echange); tft.setTextColor(ILI9341_GREEN);
tft.print("Calibration OK");
delay(1000);
return true;
324 }

326 bool tft_estCalibre() { return calibre;
328 }

330 Adafruit_ILI9341 &tft_get() { return tft;
332 }
Dossier de conception AssistDomo - SAE3.ESE.01-02 - Maximilien SEGUIER | 23 / 27

# Annexe B. Codes et configuration Home Assistant

Dans Home Assistant, Yuki apparaît sous son nom interne GouGouGaGAH (appareil, entités *.gougougagah_*, topics gougougagah/…).

# B.1 Installation et intégration MQTT

Élément | Configuration
Serveur | Raspberry Pi 3, Home Assistant OS 18.4, en WiFi 2,4 GHz, adresse fixe 192.168.1.110, interface web http://192.168.1.110:8123
Broker MQTT | Module complémentaire Mosquitto broker (configuration par défaut, port 1883)
Compte de la carte | Utilisateur Home Assistant esp32 (Paramètres → Personnes), utilisé par la carte pour se connecter au broker
Intégration | MQTT (Paramètres → Appareils et services), découverte activée, préfixe homeassistant
Accès distant | VPN Tailscale installé comme application Home Assistant sur le Pi : aucun port ouvert sur la box ; le tableau de bord est joint depuis un smartphone (réseau mobile) à l'adresse Tailscale du Pi, port 8123. Testé et fonctionnel.

# B.2 Messages MQTT échangés

Topic | Sens | Contenu
gougougagah/etat | ESP32
| → HA | JSON des mesures toutes les 10 s, ex. :
| | {"lux":215.8,"temperature":21.4,"pression":1012.6,"gaz":812,"badges":2,"tempo_jour":"BLEU","tempo_demain":"B
gougougagah/porte | ESP32
| → HA | ON (ouverte) / OFF
gougougagah/porte/ouvrir | HA →
| ESP32 | ordre d'ouverture (relais collé 3 s)
gougougagah/pwm, …/pwm/set | les
| deux | rapport cyclique 0 à 100
gougougagah/badge | ESP32
| → HA | {"uid":"A1B2C3D4","resultat":"autorise"}
gougougagah/ordre | HA →
| ESP32 | ordre texte d'une automatisation (pergola, volets…), affiché au moniteur série et sur l'écran Infos
gougougagah/dispo | ESP32
| → HA | online / offline (testament MQTT)
homeassistant/status | HA →
| ESP32 | online au redémarrage de HA : la carte renvoie ses annonces

# B.3 Entités créées par découverte MQTT

À chaque connexion, la carte publie (message retenu) une annonce sur homeassistant/<type>/gougougagah_<id>/config. Aucune ligne de YAML

## n'est donc nécessaire pour créer les entités. Exemple d'annonce pour la température :

1 {
2 | "uniq_id": "gougougagah_temperature",
3 | "name": "Temperature",
4 | "stat_t": "gougougagah/etat",
5 | "val_tpl": "{{ value_json.temperature }}",
6 | "stat_cla": "measurement",
7 | "dev_cla": "temperature",
8 | "unit_of_meas": "°C",
9 | "dev": {
10 | "ids": [
11 | "gougougagah"
12 | ],
13 | "name": "GouGouGaGAH",
14 | "mf": "Witherwatch",
15 | "mdl": "ESP32-C6"
16 | },
17 | "avty_t": "gougougagah/dispo"
18 }
Entité | Grandeur | Source MQTT
sensor.gougougagah_luminosite | Luminosité (lx) | gougougagah/etat → lux
sensor.gougougagah_temperature | Température (°C) | gougougagah/etat → temperature
sensor.gougougagah_pression | Pression (hPa) | gougougagah/etat → pression
sensor.gougougagah_gaz_brut | Gaz (valeur brute 0-4095) | gougougagah/etat → gaz
sensor.gougougagah_badges_autorises | Nombre de badges autorisés | gougougagah/etat → badges
sensor.gougougagah_tempo_aujourd_hui | Couleur Tempo du jour | gougougagah/etat → tempo_jour
sensor.gougougagah_tempo_demain | Couleur Tempo du lendemain | gougougagah/etat → tempo_demain
sensor.gougougagah_dernier_badge | UID du dernier badge présenté | gougougagah/badge → uid
sensor.gougougagah_dernier_acces | Résultat (autorise, refuse, ajoute…) | gougougagah/badge → resultat
binary_sensor.gougougagah_porte | Porte ouverte / fermée | gougougagah/porte (ON / OFF)
button.gougougagah_ouvrir_la_porte | Bouton d'ouverture de la porte | gougougagah/porte/ouvrir
number.gougougagah_eclairage | Curseur PWM 0-100 % | gougougagah/pwm/set, état gougougagah/pwm

# B.4 Tableau de bord, automatisations et scripts (YAML)

## automations.yaml

1 # Automatisations AssistDomo (Paramètres > Automatisations et scènes)

Dossier de conception AssistDomo - SAE3.ESE.01-02 - Maximilien SEGUIER | 24 / 27

C

h

ê

é

d

s : C

é

m

> ⋮ >

M

d

f

Y

A

M

L. 34 # 1. Badge RFID présenté -> prévenir l'utilisateur 5 - id: assistdomo_badge 6 | alias: "AssistDomo - Badge RFID detecte" 7 | description: "Notification à chaque badge présenté au lecteur RC522" 8 | triggers: 9 | - trigger: mqtt

1

0

t

o

p

i

c: g

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
s: 12 - acti
o

n: p

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
a: 14 | tit
l

e: "

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
e: >

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
} : 17 | {{ trigger.payload_json.resultat }} 18 | ({{ now().strftime('%H:%M:%S') }}) 19 | - action: mqtt.publish 20 | data: 21 | topic: gougougagah/ordre 22 | payload: "NOTIF : badge {{ trigger.paylo

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
e: q

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
2. P

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
s : t

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
e, s

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
d: a

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
s: "

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
n: "

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
s: 30 - trigg
e

r: n

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
d: s

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
e: i

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
r: n

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
d: s

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
w: i

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
r: s

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
d: i

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
s: 39 t: "{{ s
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
e') | f

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
e: "

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
e') | f

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
n: >

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
{ 'e

t

e' i

f

m

i

n

[

6,7,8

]

e

l

s

e 'h

i

v

e

r' i

f

m

i

n

[

1

2,1,2

]
4

4

e

l

s

e 'p

r

i

n

t

e

m

p

s' i

f

m

i

n

[

3,4,5

]

e

l

s

e 'a

u

t

o

m

n

e' }

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
s: 46 - choo
s
e: 47 | - con
d

i

t

i

o

n

s: "

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
e: 49 | - actio
n: m

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
a: 51 | top
i

c: g

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
d: >

5

3

{

{ 'P

E

R

G

O

L

A : l

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
s' 54 | if saison == 'ete' else 'PERGOLA : lames f
e

r

m

e

e

s' }

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
}, T

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
t: 57 | - acti
o

n: m

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
a: 59 | top
i

c: g

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
d: >

6

1

{

{ 'P

E

R

G

O

L

A : l

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
s' 62 | if saison in ['hiver','automne'] else 'PERG
O

L

A : l

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
s' }

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
}, T

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
e: r

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
3. É
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
d: a

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
s: "

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
s: 70 - trigg
e

r: n

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
d: s

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
w: 3

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
s: 74 - acti
o

n: n

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
t: 76 | entit
y

_

i

d: n

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
a: 78 | val
u

e: 8

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
n: m

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
a: 81 | top
i

c: g

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
d: "

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
E : a

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
e: s

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
d: a

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
s: "

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
s: 88 - trigg
e

r: n

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
d: s

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
e: 1

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
s: 92 - acti
o

n: n

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
t: 94 | entit
y

_

i

d: n

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
a: 96 | val
u

e: 0
9

7

a

c

t

i

o

n: m

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
a: 99 | top
i

c: g

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
d: "

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
E : e

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
e: s

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
4. J

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
d: a

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
s: "

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
s: 107 - trigg
e

r: s

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
d: s

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
o: "

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
s: 111 - acti
o

n: p

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
a: 113 | tit
l

e: "

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
e: "

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
E : l

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
n: m

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
a: 117 | top
c: g

g

g

g

h

/

d
y

d: "

T

E

M

P

O : d

m

g

e, d

g

v

"
m

d

e: s

g

Dossier de conception AssistDomo - SAE3.ESE.01-02 - Maximilien SEGUIER | 25 / 27

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
f : l

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
). 3 # Les entités de l'ESP32 n'ont besoin d'aucune ligne ici : elles arrivent 4 # par la découverte MQTT (intégration MQTT + broker Mosquitto). 56 input_number: 7 | temperature_souhaitee: 8 | name: Température souhaitée 9 | min: 15

1

0

m

a

x: 3

0
1

1

s

t

e

p: 0.5
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
t: "

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
e: s

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
n: m

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
> ⋮ >

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
e : c

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
r. 4 title: AssistDomo 5 views: 6 | - title: Maison 7 | path: maison 8 | icon: mdi:home-automation 9 | cards: 10 | - type: entities 11 | title: Mesures en direct 12 | show_header_toggle: false 13 | entities: 14 | - entity: sensor.gougougagah_temperature 15 | name: Température 16 | - entity: sensor.gougougagah_luminosite 17 | name: Luminosité 18 | - entity: sensor.gougougagah_pression 19 | name: Pression 20 | - entity: sensor.gougougagah_gaz_brut 21 | name: Gaz (MQ, brut) 2223 | - type: vertical-stack 24 | cards: 25 | - type: entity 26 | entity: binary_sensor.gougougagah_porte 27 | name: Porte (gâche) 28 | - type: button 29 | entity: button.gougougagah_ouvrir_la_porte 30 | name: Ouvrir la porte 31 | icon: mdi:door-open 32 | show_state: false 33 | tap_action: 34 | action: perform-action 35 | perform_action: button.press 36 | target: 37 | entity_id: button.gougougagah_ouvrir_la_porte 3839 | - type: entities 40 | title: Commandes 41 | show_header_toggle: false 42 | entities: 43 | - entity: number.gougougagah_eclairage 44 | name: Éclairage (PWM) 45 | - entity: input_number.temperature_souhaitee 46 | name: Température souhaitée 4748 | - type: history-graph 49 | title: Température (24 h) 50 | hours_to_show: 24 51 | entities: 52 | - entity: sensor.gougougagah_temperature 53 | name: Température 54 | - entity: input_number.temperature_souhaitee 55 | name: Consigne 5657 | - type: history-graph 58 | title: Luminosité (24 h) 59 | hours_to_show: 24 60 | entities: 61 | - entity: sensor.gougougagah_luminosite 62 | name: Luminosité 6364 | - type: history-graph 65 | title: Pression (24 h) 66 | hours_to_show: 24 67 | entities: 68 | - entity: sensor.gougougagah_pression 69 | name: Pression 7071 | - type: history-graph 72 | title: Gaz MQ (24 h) 73 | hours_to_show: 24 74 | entities: 75 | - entity: sensor.gougougagah_gaz_brut 76 | name: Gaz (brut) 7778 | - type: entities 79 | title: Contrôle d'accès RFID 80 | show_header_toggle: false 81 | entities: 82 | - entity: sensor.gougougagah_dernier_badge 83 | name: Dernier badge 84 | - entity: sensor.gougougagah_dernier_acces 85 | name: Résultat 86 | - entity: sensor.gougougagah_badges_autorises 87 | name: Badges enregistrés 8889 | - type: logbook 90 | title: Historique porte et badges 91 | hours_to_show: 24 92 | entities: 93 | - binary_sensor.gougougagah_porte 94 | - sensor.gougougagah_dernier_badge 95 | - sensor.gougougagah_dernier_acces 9697 | - type: entities
Dossier de conception AssistDomo - SAE3.ESE.01-02 - Maximilien SEGUIER | 26 / 27

98 | title: Tempo EDF
99 | show_header_toggle: false
100 | entities:
101 | - entity: sensor.gougougagah_tempo_aujourd_hui
102 | name: Aujourd'hui
103 | - entity: sensor.gougougagah_tempo_demain
104 | name: Demain
Dossier de conception AssistDomo - SAE3.ESE.01-02 - Maximilien SEGUIER | 27 / 27
