SeguierMaximilien/GouGouGaGAH_DomotiqueESP32/GouGouGaGAH_KiCad/rendu_pcb.png

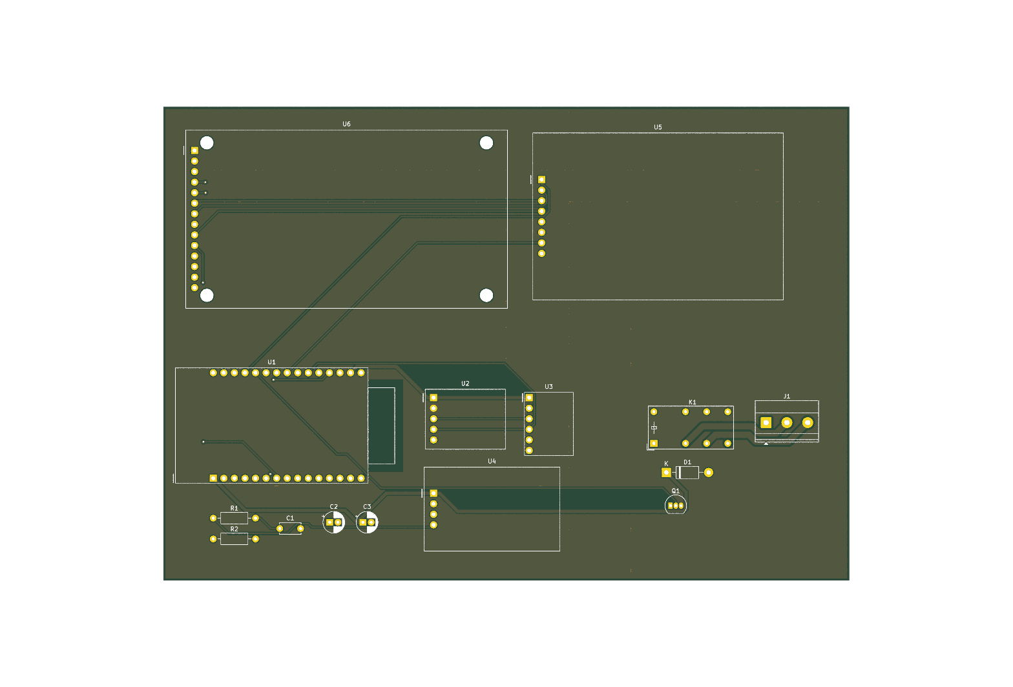
GouGouGaGAH_KiCad/rendu_pcb.png
