SeguierMaximilien/GouGouGaGAH_DomotiqueESP32/GouGouGaGAH_KiCad/rendu_pcb_dessous.png

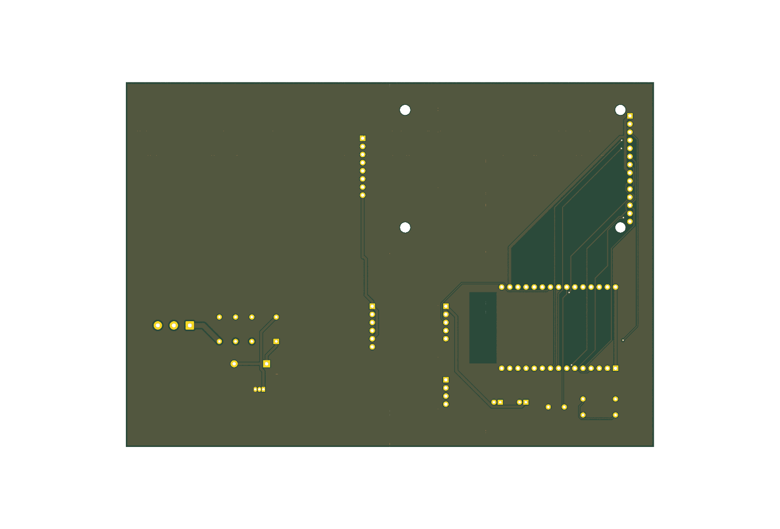
GouGouGaGAH_KiCad/rendu_pcb_dessous.png
