SeguierMaximilien/GouGouGaGAH_DomotiqueESP32/mSeguier/docs/rendu_dessous.png

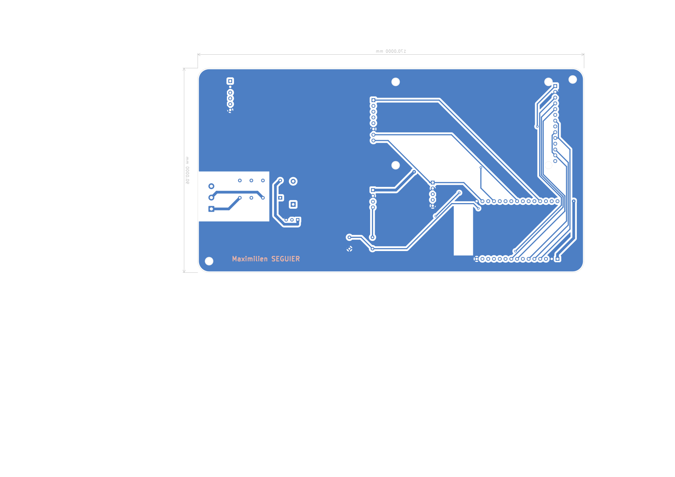
mSeguier/docs/rendu_dessous.png
