SeguierMaximilien/GouGouGaGAH_DomotiqueESP32/mSeguier/docs/rendu_dessus.png

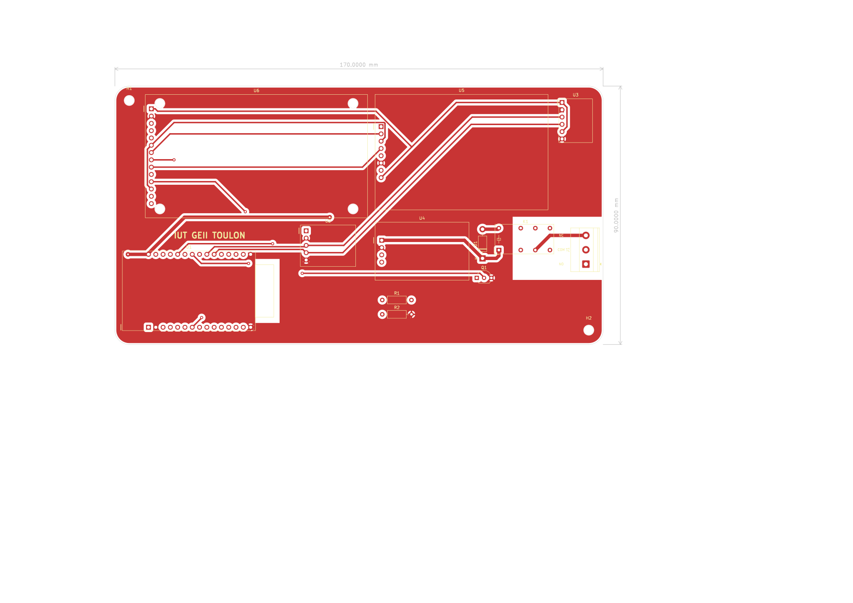
mSeguier/docs/rendu_dessus.png
