SeguierMaximilien/GouGouGaGAH_DomotiqueESP32/GouGouGaGAH_KiCad/GouGouGaGAH_KiCad_schema.pdf

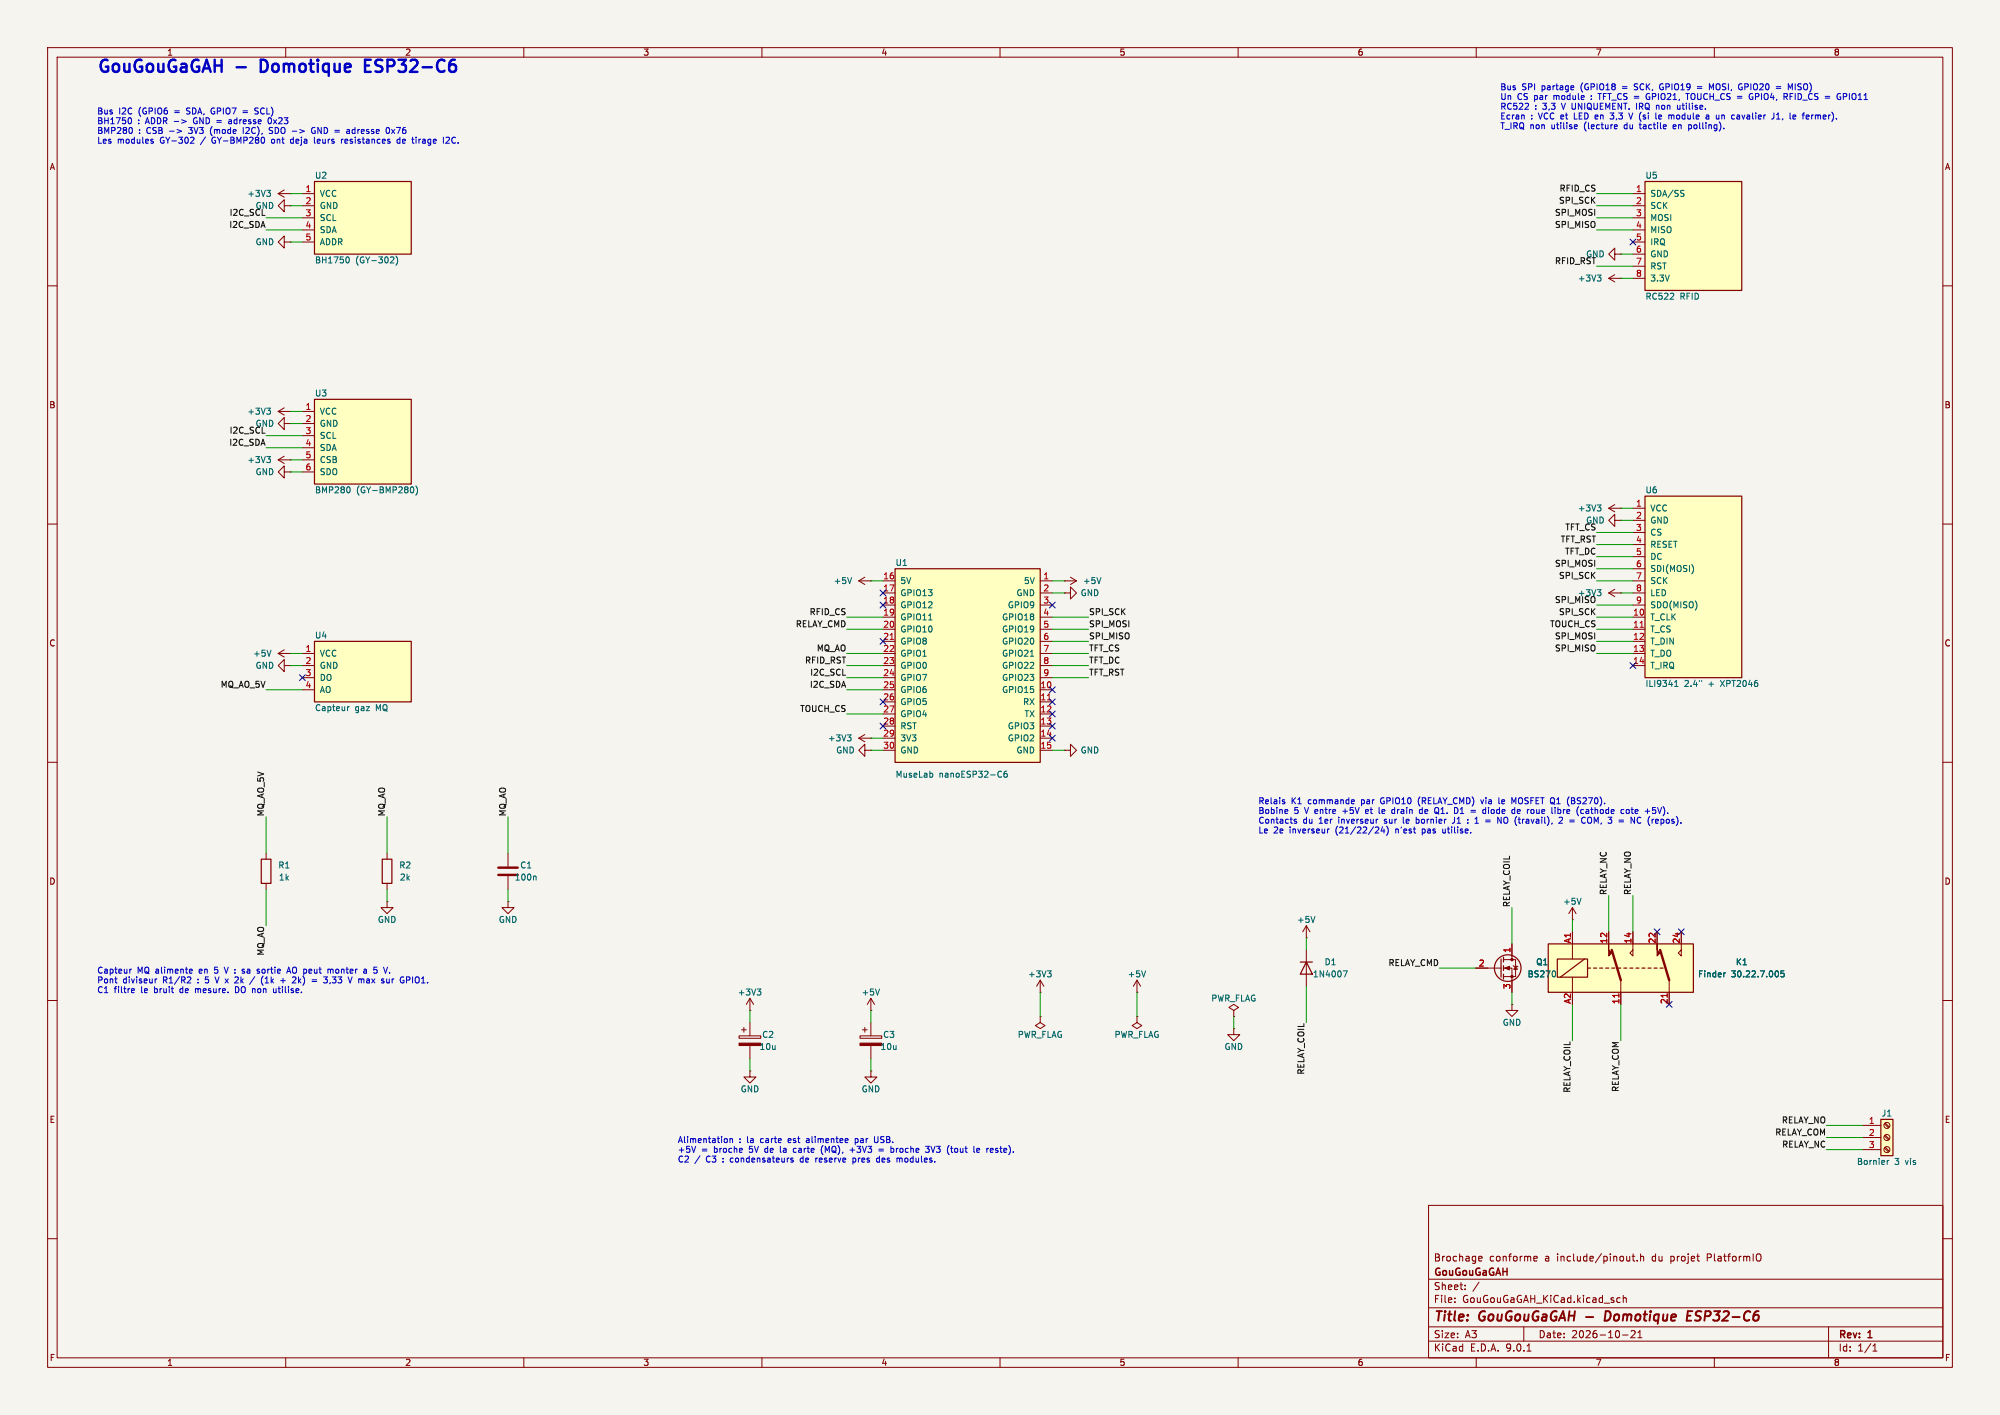
[picture p8: page 1]

VCC 1 GND 2 SCL 3 SDA 4 CSB 5 SDO 6 U3BMP280 (GY-BMP280) GND

Id: 1/1 Title: GouGouGaGAH - Domotique ESP32-C6
