SeguierMaximilien/GouGouGaGAH_DomotiqueESP32/mSeguier/docs/mSeguier_schema.pdf

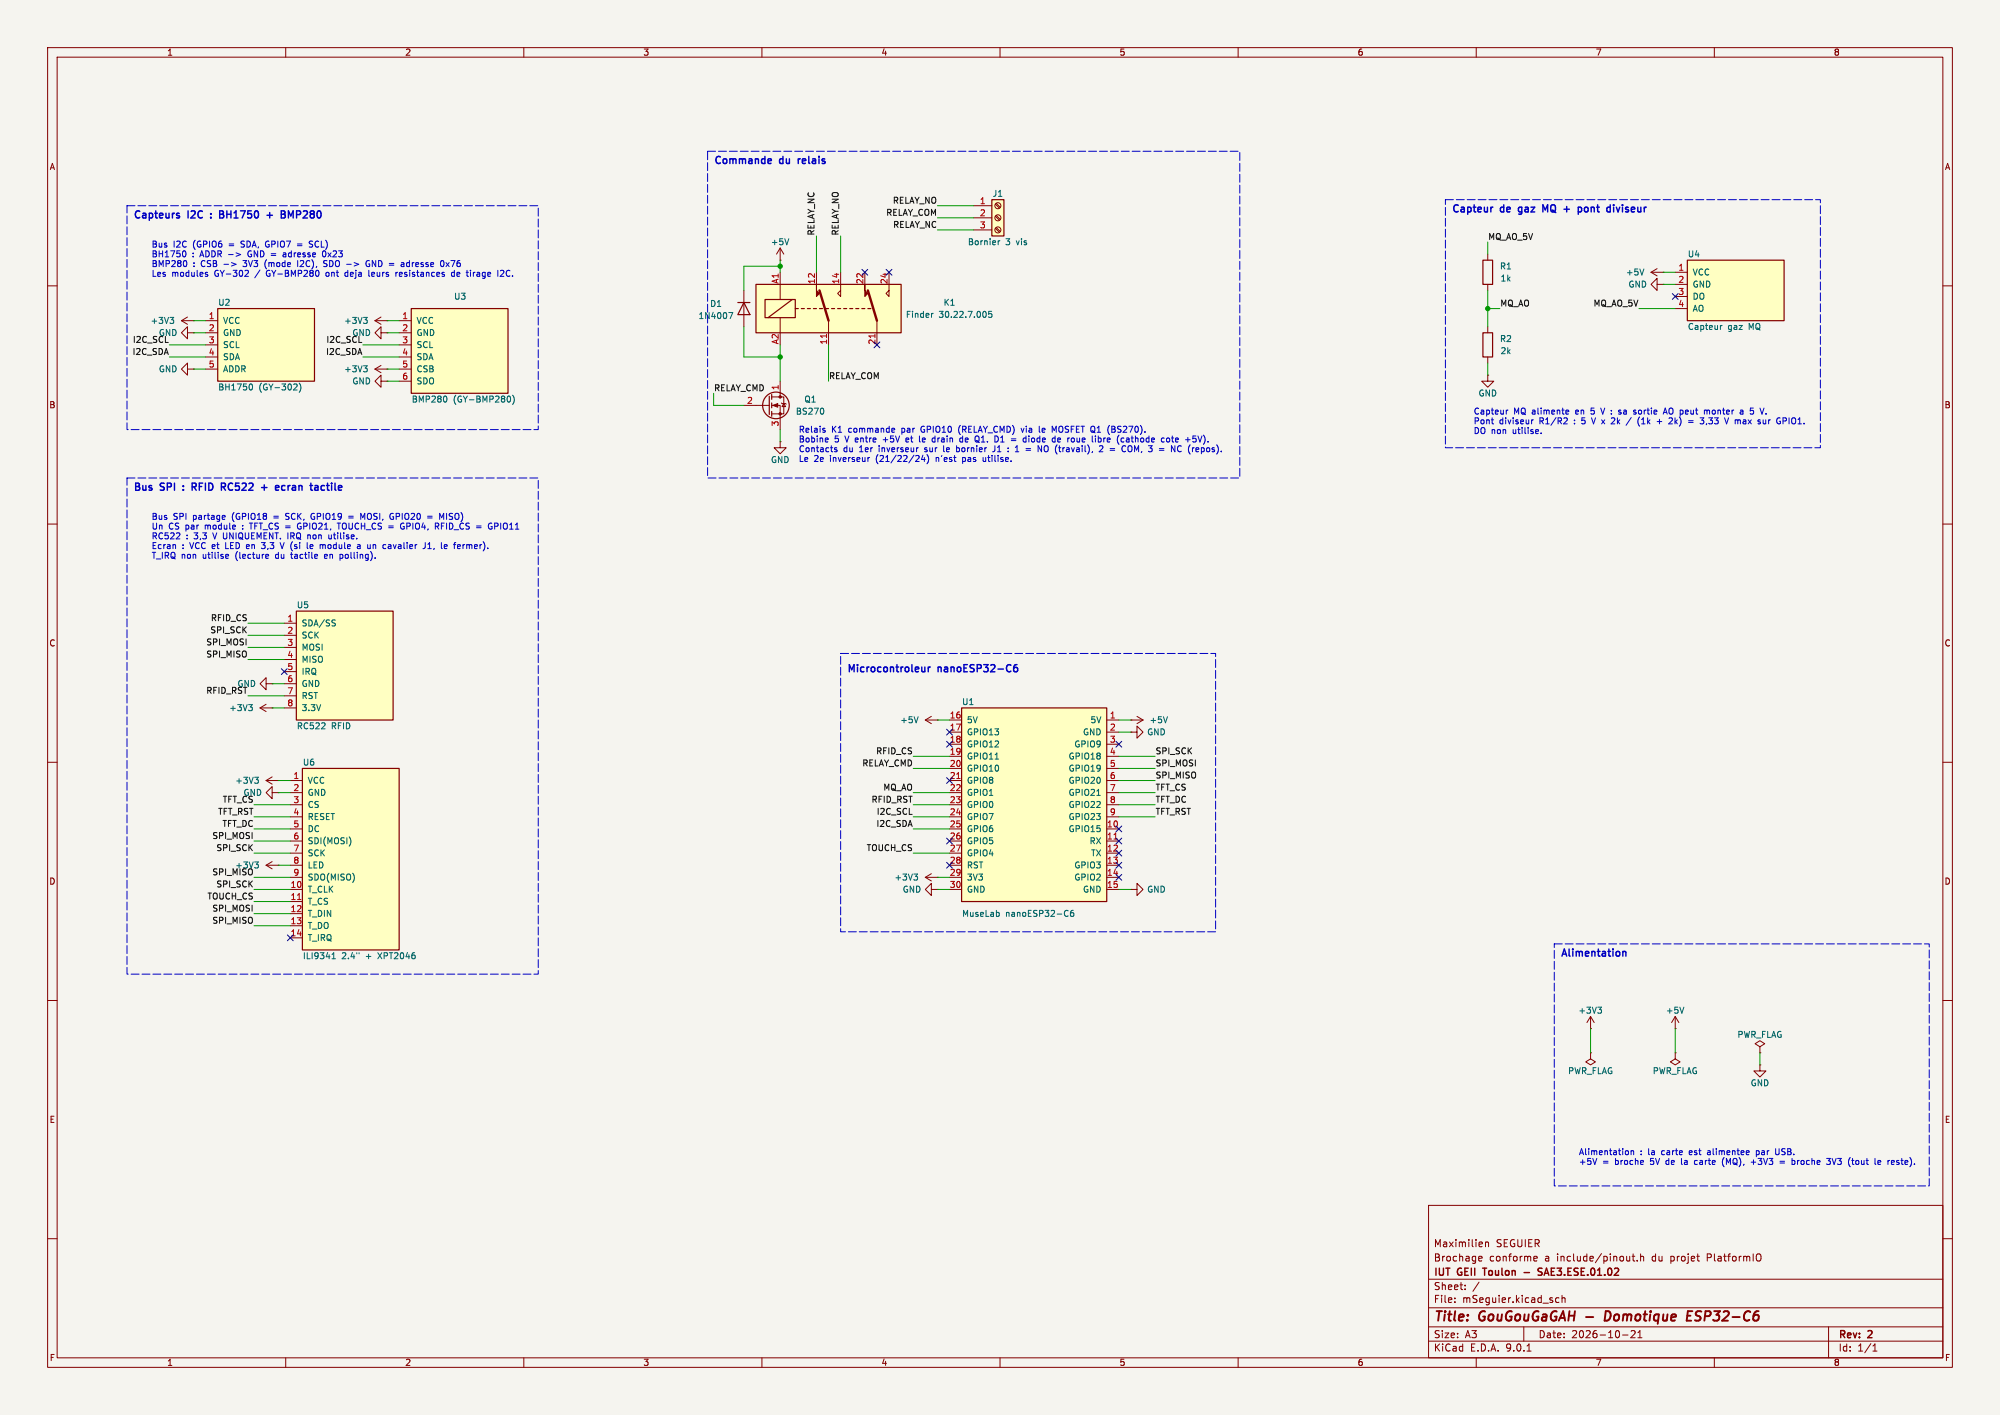
[picture p9: page 1]
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

VCC 1 GND 2 DO 3 AO 4 U4 Capteur gaz MQ

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

File: mSeguier.kicad_sch Sheet: /
Id: 1/1 Title: GouGouGaGAH - Domotique ESP32-C6
