SeguierMaximilien/GouGouGaGAH_DomotiqueESP32/mSeguier/mSeguier.kicad_pcb

## KiCad design mSeguier/mSeguier.kicad_pcb (2026-11-01)

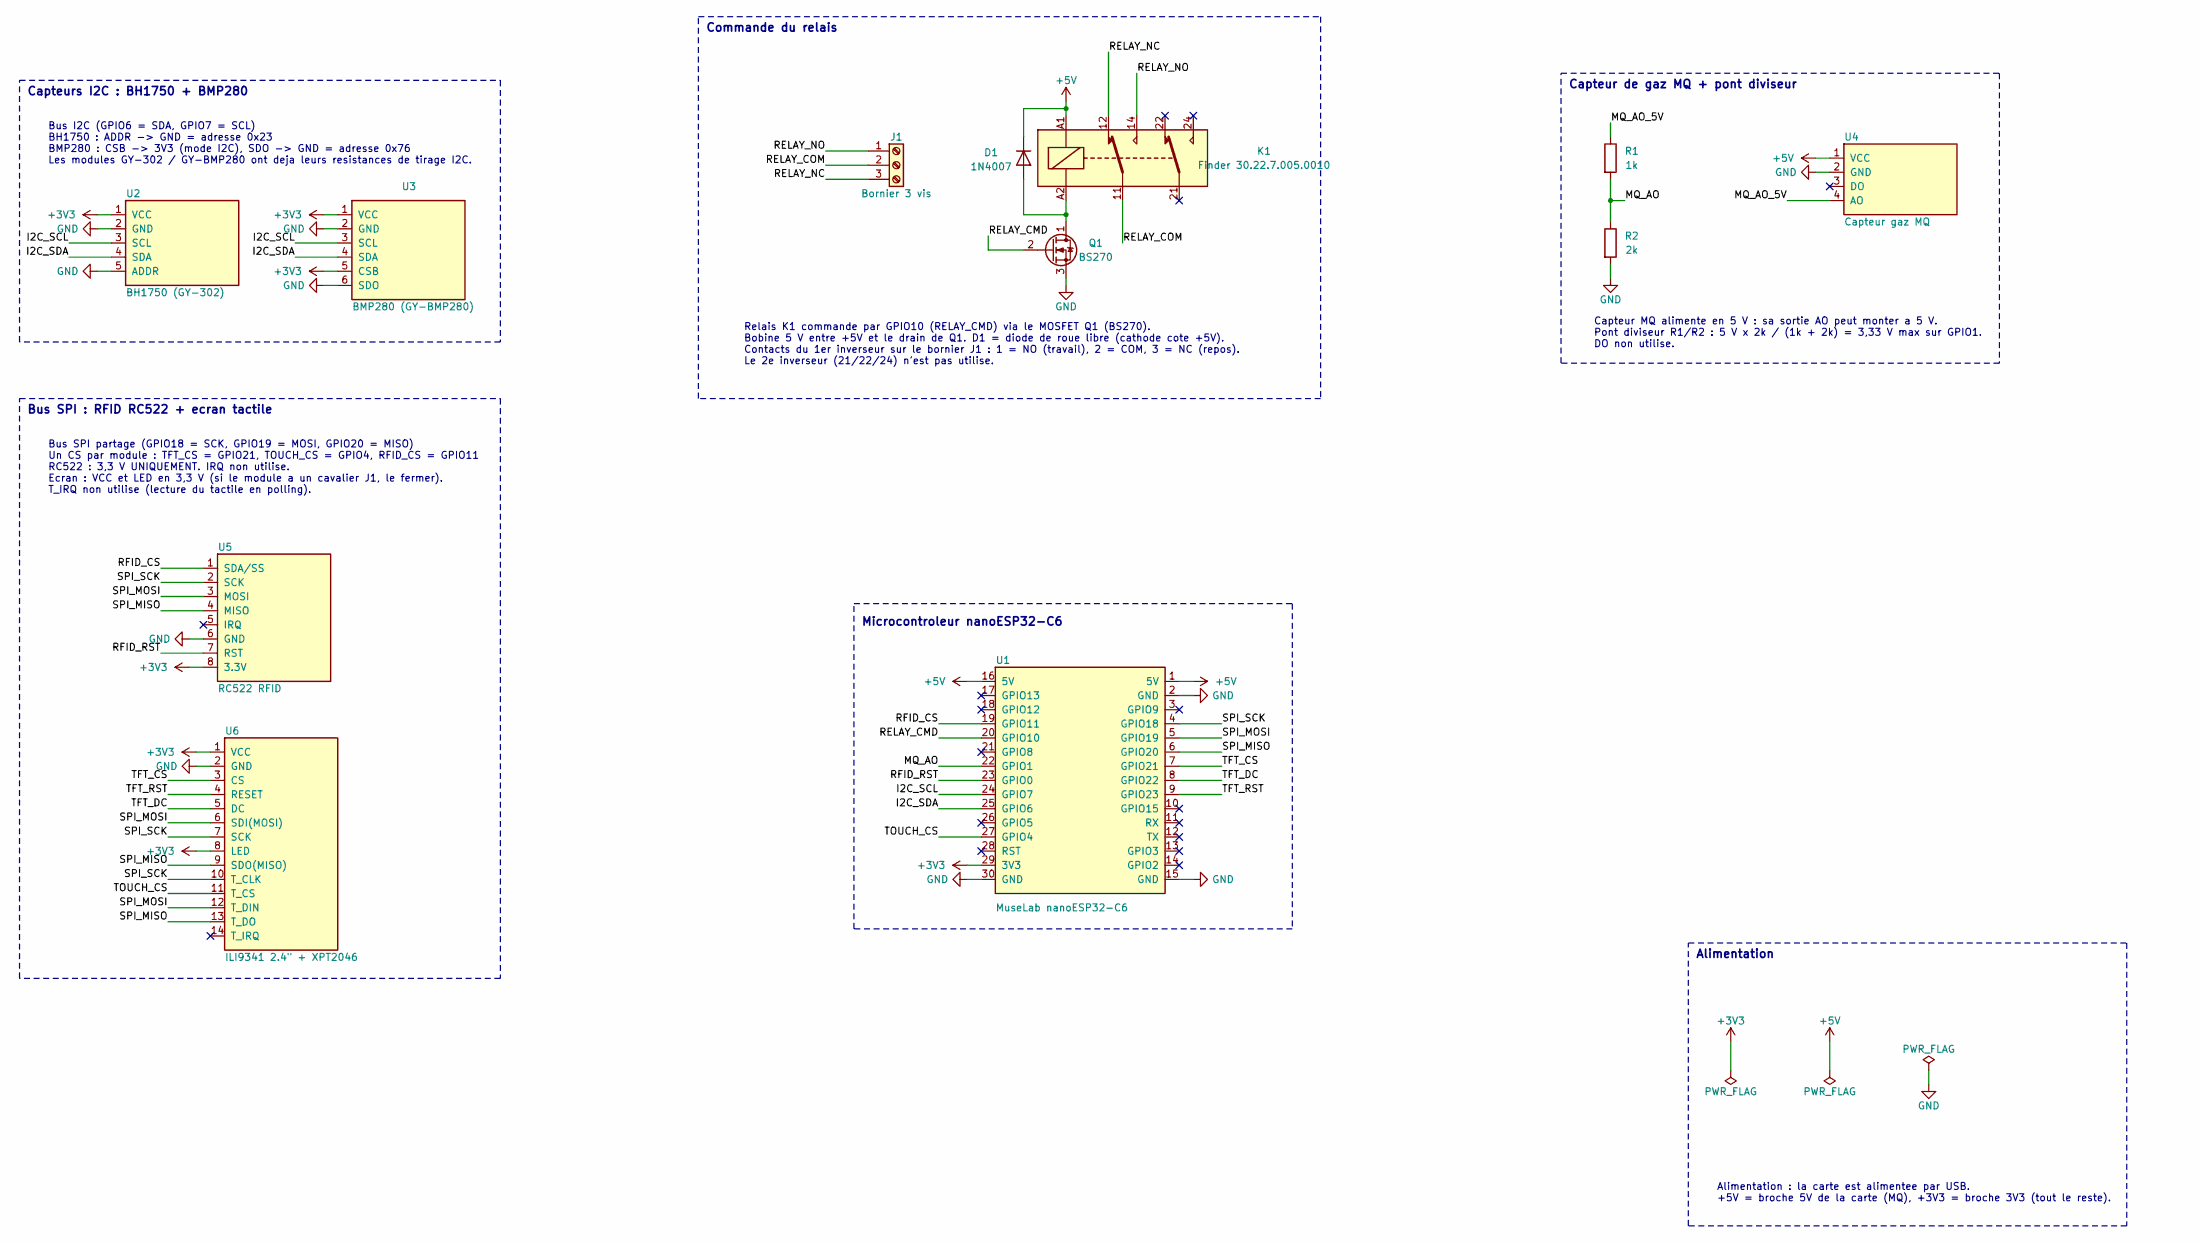
[picture p10: schematic mSeguier.kicad_sch, GouGouGaGAH - Domotique ESP32-C6]

Parts:
D1: 1N4007; D_DO-41_SOD81_P10.16mm_Horizontal
J1: Bornier 3 vis; TerminalBlock_Phoenix_MKDS-1,5-3_1x03_P5.00mm_Horizontal
K1: Finder 30.22.7.005.0010; Relay_DPDT_Finder_30.22
Q1: BS270; TO-92_Inline_Wide
R1: 1k; R_Axial_DIN0207_L6.3mm_D2.5mm_P10.16mm_Horizontal
R2: 2k; R_Axial_DIN0207_L6.3mm_D2.5mm_P10.16mm_Horizontal
U1: MuseLab nanoESP32-C6; MuseLab_nanoESP32-C6
U2: BH1750 (GY-302); BH1750_GY-302
U3: BMP280 (GY-BMP280); BMP280_GY-BMP280-3.3
U4: Capteur gaz MQ; MQ_Gas_Sensor_Module_FlyingFish
U5: RC522 RFID; RFID_RC522_Module
U6: ILI9341 2.4" + XPT2046; TFT_2.4in_SPI_ILI9341_MSP2402

Connections:
+3V3: U1.29 (3V3), U2.1 (VCC), U3.1 (VCC), U3.5 (CSB), U5.8 (3.3V), U6.1 (VCC), U6.8 (LED)
+5V: D1.1 (K), K1.A1, U1.1 (5V), U1.16 (5V), U4.1 (VCC)
/I2C_SCL: U1.24 (GPIO7), U2.3 (SCL), U3.3 (SCL)
/I2C_SDA: U1.25 (GPIO6), U2.4 (SDA), U3.4 (SDA)
/MQ_AO: R1.2, R2.1, U1.22 (GPIO1)
/MQ_AO_5V: R1.1, U4.4 (AO)
/RELAY_CMD: Q1.2 (G), U1.20 (GPIO10)
/RELAY_COM: J1.2, K1.11
/RELAY_NC: J1.3, K1.12
/RELAY_NO: J1.1, K1.14
/RFID_CS: U1.19 (GPIO11), U5.1 (SDA/SS)
/RFID_RST: U1.23 (GPIO0), U5.7 (RST)
/SPI_MISO: U1.6 (GPIO20), U5.4 (MISO), U6.9 (SDO(MISO)), U6.13 (T_DO)
/SPI_MOSI: U1.5 (GPIO19), U5.3 (MOSI), U6.6 (SDI(MOSI)), U6.12 (T_DIN)
/SPI_SCK: U1.4 (GPIO18), U5.2 (SCK), U6.7 (SCK), U6.10 (T_CLK)
/TFT_CS: U1.7 (GPIO21), U6.3 (CS)
/TFT_DC: U1.8 (GPIO22), U6.5 (DC)
/TFT_RST: U1.9 (GPIO23), U6.4 (RESET)
/TOUCH_CS: U1.27 (GPIO4), U6.11 (T_CS)
GND: Q1.3 (S), R2.2, U1.2 (GND), U1.15 (GND), U1.30 (GND), U2.2 (GND), U2.5 (ADDR), U3.2 (GND), U3.6 (SDO), U4.2 (GND), U5.6 (GND), U6.2 (GND)
unnamed: D1.2 (A), K1.A2, Q1.1 (D)

Notes on the sheet:
Capteur de gaz MQ + pont diviseur
Bus SPI : RFID RC522 + ecran tactile
Bus SPI partage (GPIO18 = SCK, GPIO19 = MOSI, GPIO20 = MISO) Un CS par module : TFT_CS = GPIO21, TOUCH_CS = GPIO4, RFID_CS = GPIO11 RC522 : 3,3 V UNIQUEMENT. IRQ non utilise. Ecran : VCC et LED en 3,3 V (si le module a un cavalier J1, le fermer). T_IRQ non utilise (lecture du tactile en polling).
Capteurs I2C : BH1750 + BMP280
Commande du relais
Alimentation
Relais K1 commande par GPIO10 (RELAY_CMD) via le MOSFET Q1 (BS270). Bobine 5 V entre +5V et le drain de Q1. D1 = diode de roue libre (cathode cote +5V). Contacts du 1er inverseur sur le bornier J1 : 1 = NO (travail), 2 = COM, 3 = NC (repos). Le 2e inverseur (21/22/24) n'est pas utilise.
Alimentation : la carte est alimentee par USB. +5V = broche 5V de la carte (MQ), +3V3 = broche 3V3 (tout le reste).
Microcontroleur nanoESP32-C6
Capteur MQ alimente en 5 V : sa sortie AO peut monter a 5 V. Pont diviseur R1/R2 : 5 V x 2k / (1k + 2k) = 3,33 V max sur GPIO1. DO non utilise.
Bus I2C (GPIO6 = SDA, GPIO7 = SCL) BH1750 : ADDR -> GND = adresse 0x23 BMP280 : CSB -> 3V3 (mode I2C), SDO -> GND = adresse 0x76 Les modules GY-302 / GY-BMP280 ont deja leurs resistances de tirage I2C.

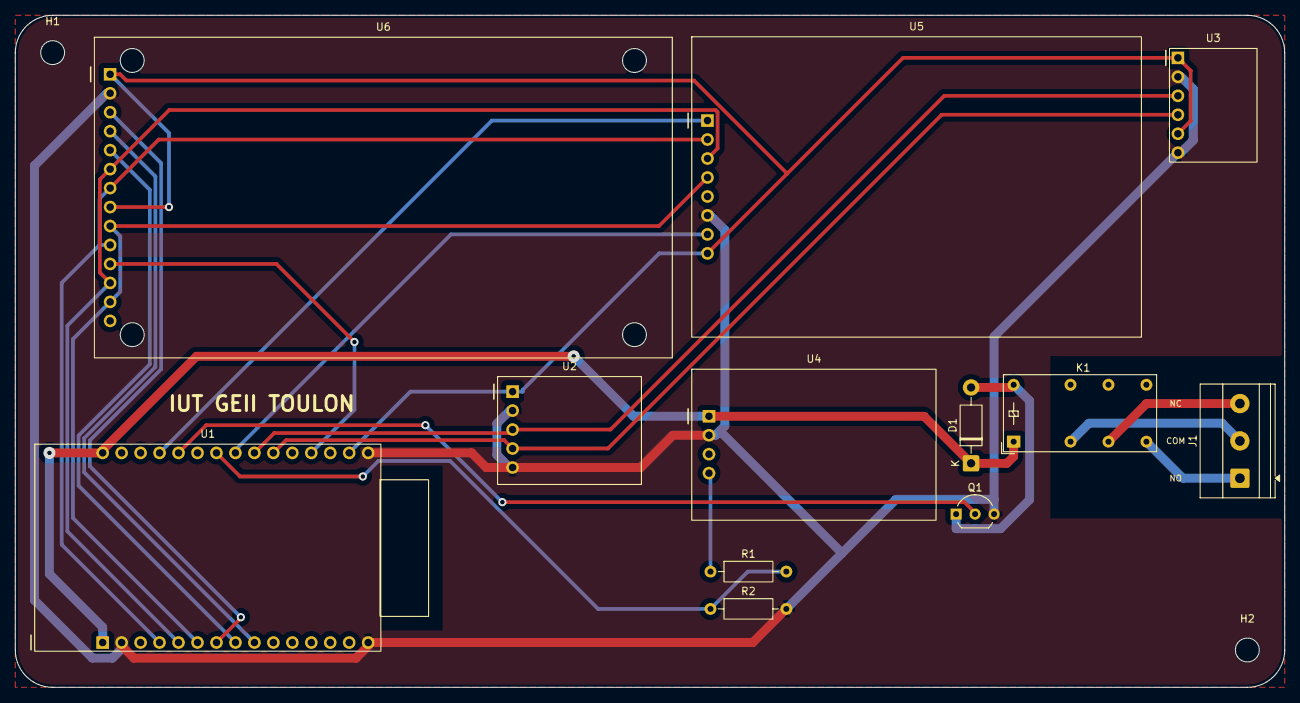
[picture p11: board mSeguier.kicad_pcb from above]

Board: 2 copper layers, 170.0 x 90.0 mm, 14 parts (0 on the bottom side), 21 nets.

Other parts of the board:
H1, H2: M3; MountingHole_3.2mm_M3
