SeguierMaximilien/GouGouGaGAH_DomotiqueESP32/GouGouGaGAH_Application/include/pinout.h

#ifndef PINOUT_H
#define PINOUT_H

// ========================================================
// PINOUT - ESP32-C6-WROOM
// ========================================================

// ---- Bus I2C (BH1750 + BMP280) ----
#define I2C_SDA     6
#define I2C_SCL     7

// ---- Bus SPI partagé (TFT + Tactile + RC522) ----
#define SPI_SCK     18
#define SPI_MOSI    19
#define SPI_MISO    20

// ---- Ecran TFT ----
#define TFT_CS      21
#define TFT_DC      22
#define TFT_RST     23
// LED (retroeclairage) -> 3V3 direct, pas de GPIO

// ---- Tactile (partage SPI_SCK / SPI_MOSI / SPI_MISO) ----
#define TOUCH_CS    4

// ---- RFID RC522 (partage SPI_SCK / SPI_MOSI / SPI_MISO) ----
#define RFID_CS     11
#define RFID_RST    0

// ---- Capteur MQ (analogique) ----
#define MQ_AO       1

// ---- Relais (via transistor, actif a l'etat haut) ----
#define RELAIS_PIN  10

// ---- LED RGB intégrée à la carte (WS2812) : couleur Tempo EDF ----
#define LED_RGB     8

// ---- Sortie PWM (gradation d'éclairage / vitesse VMC) ----
#define PWM_PIN     2

#endif // PINOUT_H
