SeguierMaximilien/GouGouGaGAH_DomotiqueESP32/GouGouGaGAH_Application/include/module_tft.h

#ifndef MODULE_TFT_H
#define MODULE_TFT_H

#include <Arduino.h>
#include <Adafruit_ILI9341.h>

// Initialise l'écran TFT ILI9341 et le tactile XPT2046
// (SPI.begin() doit déjà avoir été appelé).
void tft_setup();

// Affiche un écran de test (blocs de couleur + texte).
void tft_showTestScreen();

// Affiche une ligne de texte à une position donnée (petit helper).
void tft_printLine(int x, int y, const String &text);

// À appeler régulièrement dans loop(). Si l'écran est touché,
// remplit x/y avec les coordonnées brutes et retourne true.
bool tft_checkTouch(int &x, int &y);

// Comme tft_checkTouch, mais convertit en pixels écran (0..tft.width()-1, 0..tft.height()-1)
// avec la calibration enregistrée (voir tft_calibrerTactile).
bool tft_checkTouchPixel(int &x, int &y);

// Affiche 4 croix à toucher, calcule la calibration et l'enregistre en flash.
// Bloquant pendant la calibration. Retourne false si les points sont incohérents.
bool tft_calibrerTactile();

// true si une calibration a déjà été enregistrée.
bool tft_estCalibre();

// Accès direct à l'écran, pour les modules qui dessinent eux-mêmes (menu...).
Adafruit_ILI9341 &tft_get();

#endif // MODULE_TFT_H
