SeguierMaximilien/GouGouGaGAH_DomotiqueESP32/(commit log)

2026-09-13 Initialize repository Git settings
    Add standard Git configuration for line-ending normalization and ignore compiled C/C++ artifacts, libraries, and executables. This establishes a clean baseline for the ESP32 project and prevents generated files from being tracked.
2026-09-21 Clean project scaffold and README note
    This commit removes the default Arduino template code from src/main.cpp and adds a placeholder note to lib/README. The project is left with a minimal scaffold instead of generated example boilerplate.
2026-09-21 Configure ESP32 peripheral pins
    Add board-level pin mappings for the I2C and SPI peripherals used by the project. This sets up the BH1750/BMP280 I2C bus, shared SPI lines for the TFT, touchscreen, and RC522 RFID module, and defines the TFT, touch, RFID, and MQ-related GPIO assignments in the main sketch.
2026-09-21 Extract ESP32 pin mapping to header
    Moved the board-specific GPIO and bus definitions out of main.cpp into a dedicated include/PINOUT.h file. This centralizes the hardware configuration for the I2C, SPI, TFT, touch, RFID, and MQ sensor pins and keeps main.cpp focused on setup logic.
2026-09-21 Add ESP32-C6 pinout definitions
    Add a dedicated PINOUT header for the ESP32-C6-WROOM with include guards and explicit GPIO mappings for I2C, shared SPI, TFT, touch, RFID, and MQ sensor pins. This cleans up the project configuration and removes the stray obsolete comment left in main.cpp.
2026-09-22 Add ESP32 sensor and display drivers
    This commit adds the initial hardware driver layer for the ESP32 project: BH1750 light sensor, BMP280 temperature and pressure sensor, MQ analog sensor, RFID reader, TFT display, and XPT2046 touch screen. Each module exposes init and read helpers aligned with the project pinout and common I2C/SPI wiring assumptions.
2026-09-24 Standardize ESP32 module naming and setup API
    This commit renames the legacy sensor and display files to a consistent module_* naming scheme and updates the public APIs from init() to setup() with clearer helper semantics. It also adds explicit serial diagnostics for each peripheral and consolidates the TFT and touch logic into a single module interface. The PINOUT header cleanup is included as a small consistency fix.
    [module_bh1750.cpp, module_bh1750.h, module_bmp280.cpp, module_bmp280.h, module_mq.cpp, module_mq.h, module_rfid.cpp, module_rfid.h]
2026-10-06 Fix PINOUT header include casing
    The source file was including pinout.h while the repository header is named PINOUT.h. On case-sensitive filesystems, this breaks compilation. This change updates the include to match the actual header filename.
    [main.cpp]
2026-10-15 Initialize KiCad project files
    This commit adds the initial KiCad project structure for the GouGouGaGAH schematic, including the PCB, schematic, project settings, and backup archive. It also adds the KiCad libraries archive used by the design.
    [GouGouGaGAH_Schematics.kicad_pcb, GouGouGaGAH_Schematics.kicad_sch]
2026-10-21 Débloque la compilation et ajoute un menu de test tactile
    - platformio.ini : ajoute les lib_deps manquantes (BH1750, BMP280,
    Adafruit GFX/ILI9341, XPT2046, MFRC522) et monitor_speed
    - main.cpp : corrige l'include "pinout.h", démarre I2C/SPI, désélectionne
    les CS, initialise tous les modules et lance le menu
    - module_menu : menu tactile avec un écran de test par composant
    - module_tft : écran clone (mémoire native 320x240), SPI à 20 MHz,
    diagnostic série, test d'orientation au démarrage, tactile en pixels
    Claude-Session: https://claude.ai/code/session_01Vc4m24LHmuEPh67LxXpF9d
    [main.cpp, module_menu.cpp, module_menu.h, module_tft.cpp, module_tft.h]
2026-10-21 Add KiCad design for ESP32-C6 domotics
    Add the project schematic and routed PCB for the MuseLab nanoESP32-C6 setup, including custom module footprints, project libraries, rendered previews, and component documentation.
    [GouGouGaGAH_KiCad.kicad_pcb, GouGouGaGAH_KiCad.kicad_sch]
2026-10-21 Define GPIO10 as relay control pin
    Replace the unused GPIO10 note with the `CMD_RELAY` pin definition.
2026-10-21 Add relay control and KiCad board design
    Add GPIO10 relay control with touchscreen ON/OFF status and set the TFT orientation. Include the KiCad schematic, PCB, fabrication files, and project documentation for the ESP32-C6 board.
    [mSeguier-B_Cu.gbl, mSeguier-B_Mask.gbs, mSeguier-B_Silkscreen.gbo, mSeguier-Edge_Cuts.gm1, mSeguier-F_Cu.gtl, mSeguier-F_Mask.gts, mSeguier-F_Silkscreen.gto, mSeguier-NPTH.drl]
2026-10-21 KiCad mSeguier : PCB au format KiCad 9, recalé sur le schéma (bobine du relais câblée)
    Le PCB était au format KiCad 10, illisible par KiCad 9 sous Windows.
    Il est reconstruit en KiCad 9 avec le schéma enregistré par l'utilisateur
    (réseau de la bobine renommé Net-(D1-A), gardé en classe Fort courant),
    re-routé, plans de masse re-remplis, Gerber et perçage régénérés.
    DRC KiCad 9 et 10 : 0 erreur, 0 avertissement, parité schéma OK.
    Claude-Session: https://claude.ai/code/session_018mRuxxBd7hy4gYvrch8s8D
    [mSeguier-B_Cu.gbl, mSeguier-B_Mask.gbs, mSeguier-B_Silkscreen.gbo, mSeguier-Edge_Cuts.gm1, mSeguier-F_Cu.gtl, mSeguier-F_Mask.gts, mSeguier-F_Silkscreen.gto, mSeguier-NPTH.drl]
2026-10-21 Tactile : lecture filtrée (pression + médiane), anti-rebond et écran de calibration
    La calibration (4 croix) détecte sens et échange des axes et est enregistrée
    en flash ; elle se lance au premier démarrage puis via le bouton Calib.
    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
2026-10-21 KiCad mSeguier : retour au routage précédent, schéma de l'utilisateur conservé
    Mêmes pistes et vias que la version KiCad 10 d'avant f8243e8, reportées en
    format KiCad 9 sur le schéma modifié par l'utilisateur (bobine du relais
    câblée, réseau Net-(D1-A)). DRC KiCad 9 et 10 : 0 erreur, 0 avertissement.
    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
    [mSeguier-B_Cu.gbl, mSeguier-B_Mask.gbs, mSeguier-B_Silkscreen.gbo, mSeguier-Edge_Cuts.gm1, mSeguier-F_Cu.gtl, mSeguier-F_Mask.gts, mSeguier-F_Silkscreen.gto, mSeguier-NPTH.drl]
2026-10-21 Diagnostic I2C au démarrage : état de SDA/SCL, déblocage du bus et scan des adresses
    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
2026-10-21 Retire le diagnostic I2C et la calibration tactile de main (déplacés sur la branche calibrage)
    Annule c73be37 et efd7b0c.
    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
2026-10-21 Update schematic for KiCad 10
    Upgrade the KiCad project and schematic format, refresh component symbol pin definitions, and rearrange the relay-driver wiring. Add dated project backups.
    [mSeguier.kicad_sch]
2026-10-24 KiCad mSeguier : référence complète du relais K1 (Finder 30.22.7.005.0010)
    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
    [mSeguier.kicad_pcb, mSeguier.kicad_sch]
2026-10-24 KiCad mSeguier : empreintes D1, R1, R2, J1 mises à jour depuis la bibliothèque KiCad 10
    Routage identique (mêmes pistes et vias). PCB enregistré au format KiCad 10,
    comme le schéma. Gerber et perçage régénérés. DRC KiCad 10 : 0 erreur,
    0 avertissement, parité schéma OK.
    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
    [mSeguier-B_Cu.gbl, mSeguier-B_Mask.gbs, mSeguier-B_Silkscreen.gbo, mSeguier-Edge_Cuts.gm1, mSeguier-F_Cu.gtl, mSeguier-F_Mask.gts, mSeguier-F_Silkscreen.gto, mSeguier-NPTH.drl]
2026-11-01 ESP32 : WiFi + MQTT vers Home Assistant avec découverte automatique
    Nouveau module module_ha : capteurs (lux, température, pression, gaz),
    relais pilotable et dernier badge RFID apparaissent tout seuls dans
    Home Assistant. Identifiants dans include/secrets.h (non suivi par git,
    modèle dans secrets_exemple.h). Ajout de PubSubClient.
    Claude-Session: https://claude.ai/code/session_016MxQ9KWCSYnPW98wVUwnPm
2026-11-01 Programme final dans son propre dossier GouGouGaGAH_Application
    Le programme de test (GouGouGaGAH_DomotiqueESP32) redevient identique à main.
    Le programme final ajoute, en plus du WiFi + MQTT :
    - badges autorisés mémorisés en NVS, ouverture de la porte (relais 3 s)
    - écran : Capteurs, Porte, Badges (ajout/suppression), Éclairage, Infos
    - sortie PWM (GPIO2) pilotable depuis l'écran et Home Assistant
    - LED RGB (GPIO8) : couleur Tempo EDF du jour et du lendemain, clignotante
    - partition huge_app (le programme dépasse 1,2 Mo)
    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
2026-11-01 Application : calibration du tactile reprise de la branche calibrage
    Écran de calibration à 4 croix (enregistrée en NVS), lecture filtrée
    (pression + médiane) et anti-rebond. Calibration imposée au premier
    démarrage, puis bouton « Calib. » dans le menu pour la refaire.
    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
2026-11-01 Tempo : requêtes dans une tâche de fond, http puis https
    La lecture de la couleur Tempo bloquait loop() jusqu'à 30 s par requête
    quand la poignée de main TLS échouait (écran, badges et MQTT figés).
    Elle tourne maintenant dans une tâche FreeRTOS, essaie d'abord en http
    puis en https, avec des délais d'attente courts.
    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
2026-11-01 Ordres Home Assistant vers l'ESP32 + config HA (tableau de bord, automatisations) + guide vidéo
    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
2026-11-01 Dossier de conception : PDF (schéma fonctionnel, structurel, captures HA, annexes code + YAML) et son générateur
    Claude-Session: https://claude.ai/code/session_016MxQ9GquGY2Dk7H6nW9VW2
2026-11-01 Tableau de bord : courbes sur 2 h pour qu'elles se remplissent vite
    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
2026-11-01 Dossier de conception : projet présenté sous le nom Yuki, code à jour (topic ordre)
    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
2026-11-01 Dossier de conception : accès distant par VPN Tailscale (réalisé)
    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
2026-11-01 Dossier de conception : capture du tableau de bord Home Assistant
    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
2026-11-02 Application : broker MQTT sur le nouveau réseau du Pi (10.252.23.42)
    L'adresse du Pi passe dans include/config_reseau.h (suivi par git) et
    remplace celle de secrets.h. Ancienne config (192.168.1.110, WiFi
    Free_HOME caché) gardée en commentaire.
    Claude-Session: https://claude.ai/code/session_016MxQ9FpbcJmvPn4ZfaTD4w
    [config_reseau.h, module_ha.cpp, secrets_exemple.h]
